Flo1991/ws2811lichterkette/Doxy/rtf/refman.rtf

begin body

TITLE

AUTHOR
Version
CREATEDATE

Table of Contents

Table of contents

Use WS2811/WS2812 LEDs with an AVR

AAAAAAAAFFAAAAAAAAFFIntroduction
This project is about using an WS2811 or WS2812 lightstribe with an AVR controller. It is possible to handle up to 250 LEDs at the same time, so I chose an Atmega328p with enough RAM amount. If you want to handle less LEDs you can use most parts of this project with every AVR. The AVR is programmed to receive the light data over UART so you can control the LEDs by using a serial interface. The interface uses a specified simple protocol which is described in Protocol overview section. Everything has been developed in a university course to control the lights of a Christmas tree. In the original implementation there were some further components included. This is a simplified version of the implementation so that everyone can use it. As an example for controlling the LEDs using a smart phone the Example usage with an ESP8266 section shows how this could be done by using a webserver on the ESP8266. You can use everything else that provide a serial interface (maybe connect with a bluetooth serial module). The structure of this documentation is split in a hardware part for the AVR that describes the basic hardware that should be used. The next part is about how the software is working on the AVR that handles the LEDs and different effects. You may include some more stuff in your own. After that you can see a small protocol overview, where you find which command can be sent to the AVR to control the LEDs. Be aware that at the initialization state all LEDs are off. At the last point you can find an example how to use the implementation with an ESP8266 with a webserver. You will find the source code for the ESP8266 and the basic hardware setup.
AAAAAAAAFIAAAAAAAAFIBasic usage
For using this implementation follow this steps:
set up the hardware as descriped in section Hardware
set the F_CPU clock to the value for your hardware
set the BAUD to the value you like, 76800 or 38400 are suggested
compile your implementation (only O1 optimization is supported)
program your AVR with your binaries
set the clock divider fuse and the clock source fuse referring to your implementation
send protocol data (see section Protocol overview) to the RX pin of the AVR over a serial device, e.g. an FTDI, ESP8266 or Arduino (UART is 8N1 on your chosen BAUD)(example data 254 6 0 1 20 22 = 0xFE 0x06 0x00 0x01 0x14 0x16)

AAAAAAAAFJAAAAAAAAFJHardware
The basic hardware you need is a AVR controller an some WS2811 or WS2812 LEDs you want to control. The AVR controller should have an hardware UART, otherwise you need to write some code for a software serial. In the project we chose an Atmega328p that has enough RAM to control 250 LEDs. The internal software structure buffers the color data for the LEDs to achieve an accurate timing, see section Software implementation. The AVR can be used with the internal clock at 8 MHz, remember to clear the clock divider fuse. Otherwise an external 8 MHz or 16 MHz clock source can be used, the definition F_CPU must be set to the frequency you chose (remember to set the fuses for an external clock source). As an example figure 1 shows using an external 16 MHz crystal. AAAAAAAAFLAAAAAAAAFL

IMAGE
As you can see in the picture the AVR is programmed by using the ISP interface. The WS2812/WS2811 get the same voltage as the AVR, the light data is available at PinB0, you may change this if you like. Referring to the LEDs be aware of the current amount they may draw if every LED has its full brightness. One WS2812 can draw up to 60 mA, so one meter with 30 LEDs already need 1,8 A. If you want to control more LEDs you may have a problem with the voltage drop along the stribe. For example if you control 180 LEDs at six meters you not only need 10,8 A, furthermore you will probably have a voltage drop up to 2 V. To reduce the voltage drop you must increase the wire size with parallel wires to you stribe. You can see the voltage drop if you set all LEDs to white. If you have only a small voltage drop every LED will have the same color. If the voltage drop is too much you can see that the last LEDs will have less blue color, so they will light in a warm white color even up to red. If you want to try out the LEDs with the AVR you can build up everything on a breadboard. Pinheaders can be soldered easy at the light stribes as you can see in figure 2. AAAAAAAAFMAAAAAAAAFM

IMAGE
The connect GND to the common ground with the AVR, 5 V should be connected to a power supply that can handle the current you need. DI is the data in line, this should be connected to PinB0 at the AVR. The stribe is like a big shifting register, all the data you sent is shifted bit by bit through the stribe. So DO is the data out pin, you see some data at this pin if all LEDs before had already received their color data. The one wire protocol of the LEDs is described in the next section Software implementation.
Datasheets:
Datasheet WS2812
Datasheet WS2811
Datasheet Atmega328

AAAAAAAAFKAAAAAAAAFKSoftware implementation
If your hardware is ready you must flash your AVR device with the provided software. Therefore the ISP-6 connector should be used. To get the right timing remember to set the F_CPU definition to the frequency you are working at. Furthermore set the fuses of the AVR referring to your implementation. This means you have to clear the clock divider fuse and may have to change the clock source. I suggest to use the AtmelStudio to program your AVR and its fuses.
The WS2812/WS2811 are controlled by one data line that works with a one wire protocol. Because of the missing clock line the timing is really important, this can either be achieved by doing some trick with the hardware interfaces (e.g. using the spi interface) or by bit banging. In this implementation bit banging is used. To get a good timing all color data must be transmitted in one block that is not interrupted by some other code. The timing specifications of the WS2812/WS2811 LEDs can be found in table 1 which refers to the datasheet ( WS2812 ).
AAAAAAAAFNAAAAAAAAFN
Information | Timing | Tolerance +/-
Transfer 1 Bit | HighTime+LowTime=1,25 µs | 600 ns
send 0, high time | 0,35 µs | 150 ns
send 0, low time | 0,8 µs | 150 ns
send 1, high time | 0,7 µs | 150 ns
send 1, low time | 0,6 µs | 150 ns
data transmission complete, low time | >50 µs | -
Timing table for WS2812/WS2811 one wire protocol
The timing is done by setting the output and wait the required time by doing nothing (call assembly NOPs). So it is important to compile the provided software at O1, other optimization levels may influence the timing. To send one bit (either high or low) two different macros are defined in Lightstribe.h (SETHIGH and SETLOW), one LED needs 24 color bits. The macros depend on the value of F_CPU you entered in globals.h. Furthermore the header file Lightstrib.h declares a color struct to handle 24 bit colors (color24bit) and three basic functions to control the LEDs. The corresponding c file Lightstribe.c implements these functions. The most important function is the transmit2leds function. This function and only this function transmits data to the stribe. All other functions either call this function or manipulate the color array. To achieve the right timing all effects and operations are done on a color array that stores the color information for the LEDs. The information is sent to the LEDs by calling transmit2leds with the lightdata pointer that points to an dynamically allocated array that stores the color information depending on the number of LEDs you want to control. Therefore your color array must at least be able to contain 24 bits x your number of LEDs. It can be bigger, what will allow you to create even more effects (e.g. if you rotate a rainbow array). So the effects that are implemented in LedEffects.c change the color array and afterwards the transmit2leds is called. The c file LedEffects.c not only contains effects but also different necessary functions for the effects and the serial color handling. The colorconv8to24 function converts the received 8 bit colors from the serial port to 24 bit colors for the lightstribes. So you only sent 8 bit colors over the serial port to the AVR to reduce data size. Further information can be found in the Protocol overview section. The colors are decompressed with a simple map function you may know from Arduino. The main.c file initializes the hardware and handles the LEDs. A serial interrupt stores the data temporary. If the data transmission is complete the main function will extract the information and set the new configuration for the lightstribe.
The last points to be mentioned in this section are some things you need to be careful. The first thing is that the 8 bit colors are in an RGB 3-3-2 format. The 24 bit color format depend on the LEDs. WS2812 LEDs use a GRB color scheme while WS2811 use a RGB color scheme. This is important, to achieve the right color the protocol includes a bit that decides the color scheme. The right color is resolved by the decompressing function colorconv8to24. Another thing is that the colors are not linearized, what means that you cannot say that a color you got from a color table will be look like this. As an example you picked an orange from a 3-3-2 rgb color table. This orange will not be the same orange on the LED stribe. This depends on many parameters so linearizing is too much effort and almost impossible (to achieve linearization you would have to measure each color, compare it and evaluate correction parameters).
AAAAAAAAFGAAAAAAAAFGProtocol overview
This section gives an overview of the implemented serial protocol. The goal of the protocol was to be as simple as possible, to be easily implemented on the AVR and to use as less resources as possible. Figure 3 shows the base structure of the protocol. AAAAAAAAFOAAAAAAAAFO

IMAGE
As you can see a data transmission always starts with the preamble 254(0xFE). For a fast and easy implementation this preamble value must only be used as preamble and must never be another field value (e.g. you must not send the color value 254). The next byte that is sent contains the total length of the packet including the preamble and the length byte. If you sent a wrong length you may get an unexpected behavior until a new correct data packet is sent. The third field contains the effect. The different effects are listed in table XXX. In Bit 7 (MSb) you can choose the LED type you want to control, set the bit to 0 for WS2811 and to 1 for WS2812 LEDs. The next byte is a value to control the effect speed. You can set a delay between 0 (no delay) and 250 (longest delay possible). The value unit and is not a repeatable setting for different effects. This means that the delay is no correct wait function (e.g. wait for n milliseconds). Furthermore the effects work on the color array what may be faster for some effects and slower for others. The best thing is to try the effects with different values. The next field contains the number of the LEDs that should be controlled. Be aware that the maximum supported number of LEDs is 250, but this depends on your hardware. The chosen Atmega328p can handle this amount, if you choose an AVR with less RAM this will not work. What you can do is to allocate more LEDs than you actually have. This gives you the possibility to create further effects. What happens is that only a part of the array is sent to the LEDs but the other color values are stored internally in the AVR (in fact all color data is transmitted to the LEDs but the superfluous information is overwritten by new data). The last data field are the color values. One color is 8 bit RGB 3-3-2 and you should sent the right amount of colors for your chosen effect. If you sent to less information the data block will not be evaluated because the total length does not match. For sending some data do not forget to configure your UART (8N1 BAUD) on both sides.
AAAAAAAAFPAAAAAAAAFP
Effect number | Number of colors (1 byte RGB 3-3-2) | Description | Example (decimal)
0 = SETFULLCOLOR | 1 | All LEDs glow at the same color without changes. | 254 6 1 20 22
1 = FILLUP | 2 (foreground, background) | One LED steps through the stribe in the foreground color and colors all LEDs after it in the background color. At the end of the stribe the LED stays at the foreground color and another LED starts to step through the stribe. This continues until the whole stribe is filled in the foreground color. Then the stribe is cleared to the background color and the effects begins again. | 254 7 1 22 20 22 201
2 = BLINK | 1 | The stribe blinks in the chosen color and to off (=black) repeatedly. | 254 6 2 55 20 56
3 = RUNLED | 2 (foreground, background) | All LEDs but one are colored in the background color. The one in the foreground color walks through the stribe with overflowing to the beginning. | 254 7 3 55 20 56 151
5 = ALTERNATE | 2 (foreground, background) | The LEDs are alternating in the foreground and the background color. First the even LEDs are colored in foreground and the uneven in the background color, after that vice versa. | 254 7 5 55 20 56 151
7 = RECOLOR | 1 | The stribe is filled in a new color step by step until the whole stribe stays in the new color. | 254 6 7 55 20 38
8 = FADE | 1 | The destination color is set and the base colors red, green and blue are decreased step by step until the stribe is off. After that the color values are increased until the destination color is reached. This generates a color fading effect. The color fading is not linearized. | 254 6 8 55 20 201
9 = INITRAINBOW | no color | Set the stribe in a static rainbow color. | 254 5 9 0 20
10 = ROTATE_R | no color | Rotate all LEDs one step to the right side (depends on lightdata array). | 254 5 10 232 20
11 = ROTATE_L | no color | Rotate all LEDs one step to the left side (depends on lightdata array). | 254 5 11 23 20
12 = CUSTOM | N colors | All LEDs are set to the static color referring to the sent color values. If there are more LEDs than color values the colors are repeated. | 254 8 12 1 20 22 201 60
Table containing all effects available over the serial protocol
The missing numbers in table 2 are internally used by the AVR and must not be sent over the serial port.
AAAAAAAAFQAAAAAAAAFQImplement further effects
This section tells you how to implement further effects. You may use already existing functions to generate new effects or add something completely new. All effects should be written in the LedEffects.c file and declared in its header file LedEffects.h. You must know that everything works on a lightdata array that contains the colors stored in an array. The array is sent directly to the stribe if the transmit2leds function is called. So you first need to manipulate the array and than send it to the stribe. The array is ordered in GRB color because the implementation has been done for WS2812 LEDs (WS2811 LEDs can be used the colors are converted in the colorconv8to24 function referring to the MSb of the effect you sent, for more information see section Protocol overview). So lightdata[0] contains one byte green data, lightdata[1] one byte red data, lightdata[2] blue data and so on. In general you can say lightdata[N%3==0] contains green, lightdata[N%3==1], lightdata[N%3==2] data. So the color array has a size of MAXNUMCOLORS * 3. So your function must at least have a pointer to the lightdata array as a call value. For creating your effect some nice functions are already implemented you may use. You can find a list of them in table 3.
AAAAAAAAFRAAAAAAAAFR
Function Name | call values | operation
map | x,in_min,in_max,out_min,out_max | calculate an x value to a new number range
effectdelay | delay | wait some time dependend on delay
resetstribe | *lightdata | clear the stribe (all LEDs off)
rotate | *lightdata, direction | rotate stribe by one position (means 3 bytes) in direction (right/left)
rotateN | *lightdata, direction,width | rotate LEDs by "width" positions (means width * 3 bytes) in direction (right/left)
setled | color, *lightdata, lednr | set one LED a position lednr in the chosen color, others off (black)
changeled | color, *lightdata, lednr | change the color of one LED at position lednr, others are unchanged
Provided help functions for your own effect
Your written effect should get an own definition in LedEffects.h . The last thing is to add your definition in the main switch case structure. Referring to the implemented protocol your effect is available with the number you defined in LedEffects.h. You must sent the neccessary information for your effect, for example the color values you need and so on. To get the color value you sent you need to call colorconv8to24 to convert the 8 bit RGB color into a 24 bit color. All colors you sent are available in the CompColorArray. The first color you sent is stored in index zero. Your implemented function must not care about the color order if you use the colorconv8to24 function. This does the conversion depending on the MSb of the effect you sent over the serial port. The delay is handled by the global var effectime and the number of LEDs to control is stored in NumOfLeds. The effect is stored in the effect variable. You should not do any changes on the serial part and the protocol reading, otherwise you will change to complete behavior of this implementation.
AAAAAAAAFSAAAAAAAAFSRequirements and Limitations
The implementation to control has the following requirements and limitations:
colors are 8 bit compressed so you cannot get every color value of the LEDs
the protocol implementation with the preamble 254 prohibits this value for other protocol fields (e.g. color)
approximate amount of RAM (in bytes) you need: MAXNUMCOLORS(=number of LEDs to control)*3 + UART_BUFFER_SIZE *2 + MAXNUMCOLORS + 160
only O1 optimization is supported
8 MHz and 16 MHz clock support
fuses must be programmed manually (clock source and clock divider)
WS2801 stribes not supported (different hardware interface with two wires)
AVR should run on 5 V

AAAAAAAAFHAAAAAAAAFHExample usage with an ESP8266
This section gives a short introduction about using the provided programm with an ESP8266. In this example the ESP8266 works as a wifi hotspot you can connect with and browse a website which allows different settings for the light stribe. The website is quite simple and only a few effects and colors are supported. If you enter the button "DO IT" your configuration is transmitted over the serial interface to the AVR. This is done through a software serial implementation, you find all necessary files below. You should step through all instructions to get the example work.
AAAAAAAAFTAAAAAAAAFTESP8266 setup
First you need to setup the ESP8266. Because of different versions of ESP8266 modules you may miss something, this is just a quick guide. For more information you can browse the web. First you must connect your ESP8266 to a host computer over a serial interface for example using an FTDI. Remember to cross RX and TX of the serial port. Furthermore be aware of the ESP8266 voltage, it is 3,3 V. The current a serial chip may provide (some FTDIs provide some current) may not be enough for the ESP8266 and what can cause different problems.
So first you need to flash your ESP8266 with the nodemcu firmware that provides a software serial. The binaries that have been used in this example can be found here:
Binaries part 1
Binaries part 2
For uploading this binaries to the ESP8266 you should use the nodeMCUFlasher (https://github.com/nodemcu/nodemcu-flasher) that can be found on github. You need to set the serial port to which your ESP8266 is connected with and configure the source files for flashing the firmware. You need to set the COM port to which you ESP8266 is connected to (see figure 4). Furthermore you must consider the following hardware configuration:
3,3 V logic level
bootmode low (IO15)
chip enable high (CH_PD)
reset high (drive low to reset the module)
IO0 low for firmware flashing (high for programming and normal operation)
The firmware programmer waits for the MAC of the ESP8266 module which will be successfully read if everything is done fine. As you can see in figure 4 the firmware programmer is still waiting for an ESP8266. AAAAAAAAFUAAAAAAAAFU

IMAGE
If the ESP8266 is connected right you now set the configuration to the provided binaries as you can see in figure 5. You must browse to the binary files and set the destination address. Now you can hit the "Flash"-Button (see figure 4). AAAAAAAAFVAAAAAAAAFV

IMAGE
After flashing the firmware you need to reboot the ESP8266 module. Before you do this you should change the IO0 to high level (3V3) because after the reboot we want to program the module with our own program. The reset can be done by setting reset low. The program we will upload to the module is written in Lua. Lua is a scripting language that is interpreted by the firmware running on the module. So the performance is not the best, but the programming is quite simple. The little program that you can find below set up the module as an access point, runs a simple webserver that interacts with a software serial to control the AVR. One thing you must know about the Lua programming is that the variable types are assigned implicit so you cannot control whether a number is stored as 16 bit or 32 bit signed or unsigned variable. Another thing you should know is that the program you write needs the full memory space of its file. That means shorter variable names save memory and furthermore documentation should be as short as possible or left.
For writing your program you can use any text editor, notepad++ is a good choice. If you are finished you must upload the file to the module. Therefore you use the same setup as for firmware updating but you must set IO0 to high level. For uploading your program you can use the ESP8266 Lua Loader. It is easy to handle and you can try out several things first, before you upload your code. You can find the main window of the ESP8266 Lua Loader in figure 6. AAAAAAAAFWAAAAAAAAFW

IMAGE
On the right side you can set the baud rate for uploading you program to the module. In the GPIO section you can easily set and reset them to try your wiring. By using the restart button you will restart the module. This may be necessary if your heap (RAM) is to low. This is caused by inefficient programming or by a program that is to big for the module. Global variables need a lot of heap. For uploading your program hit the "Upload File..." button. In a file browser you choose your program that should be transferred to the module. After completion you hit the "dofile" button to run the program. This short description should be enough.
So now we upload the Lua program that starts the webserver and sends data over a software serial to the AVR. You can find this program here:
lua program for controlling the AVR
The program does the following:
set up the ESP8266 module as an access point (SSID=Lichterkette, password=12345678, you may change this)
start a webserver that listens on port 80
load the index.html website and handle requests
sent UART commands matching for the AVR implementation to generate different effects depending on the request
software serial is set to GPIO5 (GPIO5 is available at software number 1)
Some further things you should know:
the maximum of parallel accessing devices is four
parallel devices can never access another device
the software uart only supports TX (8N1 up to 38400 baud)
if you change the website you must change the hard coded content length of the website
the address of the ESP8266 is always 192.168.4.1

AAAAAAAAFXAAAAAAAAFXConnect ESP8266 with AVR
After uploading the main program file you need to upload the _index.html file. Before uploading remove the underscore so that the files name is index.html (the underscore has been inserted because of conflicts with this html documentation). For uploading other file types (than lua programs) to your ESP8266 module you need to use the "Upload Bin" button of the Lua Loader. The file will be uploaded to the file system on the ESP8266.
Now your ESP8266 module is ready to try the first communication with the AVR. So now you need a hardware setup where the ESP8266 and AVR are connected. Be aware of the different voltage levels (AVR uses 5V, ESP8266 3V3). You should connect everything like figure 7 shows.
AAAAAAAAFYAAAAAAAAFY

IMAGE
Your ESP8266 should still be connected with the host computer. If your hardware setup is ready you now must hit the "dofile" button in the Lua Loader (complexe_server.lua must be the selected file that should be executed). After a short time you can use any device to search for the access point that is set up by the ESP8266 module. It will have your SSID (default "Lichterkette") and your chosen password (default "12345678"). After you connected to your ESP8266 module you should open a web browser and browse the IP address 192.168.4.1. The browser should load the website. Now choose your configuration for the LEDs and hit the "DO IT" Button on the website. The website should be reloaded and the lightstribes get the configuration you have chosen. If everything is working fine the last thing to do is to make the ESP8266 as a stand alone device without the need of an external host. For this you must remove the complex_webserver.lua file from the module. Now you rename the file on your host computer to init.lua. Afterwards you upload this file to the ESP8266. This file is always loaded at first when the ESP8266 is powered on. So now you have a stand alone webserver that communicates with your AVR for controlling WS2811/WS2812 LEDs.

AAAAAAAAFZAAAAAAAAFZShort setup

flash the provided image (Binaries part 1 ,Binaries part 2
upload the _index.html renamed to index.html
upload the lua program complex_server.lua renamed to init.lua
setup your hardware refering to figure 7
connect to your ESP8266 with your SSID and your password (default: Lichterkette, 12345678)
browse 192.168.4.1 on your device
set up your configuration and hit "DO IT"

author: Florian Wank, 2016

Data Structure Index
Data Structures
Here are the data structures with brief descriptions:
color24bit (24 Bit color structure RGB 8-8-8 ) pagenum

File Index
File List
Here is a list of all documented files with brief descriptions:
globals.h (File that contains basic and global definitions, changes should be done carefully ) pagenum
LedEffects.c (Effect functions for controlling WS2811/WS2812 LEDs ) pagenum
LedEffects.h (File that contains different effect definitions for the lightstribe ) pagenum
Lightstribe.c (Basic functions for controlling WS2811/WS2812 LEDs ) pagenum
Lightstribe.h (Basic functions for controlling WS2811/WS2812 LEDs ) pagenum
ws2811lichterkette.c (Main file for interfacing WS2811/WS2812 LEDs ) pagenum

Data Structure Documentation
color24bit Struct Reference
AAAAAAAAATAAAAAAAAAT
24 Bit color structure RGB 8-8-8
#include <Lightstribe.h>

Data Fields
uint8_t redAAAAAAAAAWAAAAAAAAAW
8 Bit red
uint8_t greenAAAAAAAAAXAAAAAAAAAX
8 Bit green
uint8_t blueAAAAAAAAAVAAAAAAAAAV
8 Bit blue

Detailed Description
24 Bit color structure RGB 8-8-8
Definition at line 16 of file Lightstribe.h.

The documentation for this struct was generated from the following file:
Lightstribe.h

File Documentation
globals.h File Reference
AAAAAAAAAPAAAAAAAAAP
file that contains basic and global definitions, changes should be done carefully
#include <stdint.h>

Macros
#define _STR_EXPAND(tok) #tokAAAAAAAADIAAAAAAAADI

#define _STR(tok) _STR_EXPAND(tok)AAAAAAAADJAAAAAAAADJ

#define _CPU_INFO(x) CPU_FREQUENCY##xAAAAAAAADKAAAAAAAADK

#define EXTERN externAAAAAAAAAAAAAAAAAAAA

macro for global variable management
#define BASELEDTYPE 11AAAAAAAACPAAAAAAAACP

default LED type of the stribe (11 for WS2811, do not change here! change ledtype in main function!)
#define MAXNUMCOLORS 50AAAAAAAAAFAAAAAAAAAF

definition for maximum number of different colors that can be handled at the same time (the maximum value should be 250, a higher value may result in an memory overflow refering to 2kByte (atmega328p))
#define UART_BUFFER_SIZE 80AAAAAAAAAHAAAAAAAAAH

definition for UART Buffer, must be at least MAXNUMCOLORS+5
#define F_CPU 8000000AAAAAAAADLAAAAAAAADL

CPU Frequency definition for avr delay function.
Variables
EXTERN uint8_t NumOfLedsAAAAAAAAABAAAAAAAAAB
global variable for number of leds to control
EXTERN uint16_t effectimeAAAAAAAAACAAAAAAAAAC
global effectime for effect delays, a higher value means a higher delay
EXTERN uint8_t ledtypeAAAAAAAAADAAAAAAAAAD
global ledtype, 11 = WS2811 (RGB Color), 12 = WS2812 (GRB Color)
EXTERN uint8_t CompColorArray [MAXNUMCOLORS]AAAAAAAAAEAAAAAAAAAE
color array containing the received packed 8-Bit colors
EXTERN uint8_t RecBuffer [UART_BUFFER_SIZE]AAAAAAAAAGAAAAAAAAAG
receive buffer for UART communication
EXTERN uint8_t BufferCounterAAAAAAAAAIAAAAAAAAAI
counter for accessing the CompColorArray indices for data income
EXTERN uint8_t DataLenAAAAAAAAAJAAAAAAAAAJ
variable to store the current packet length of the UART packet
EXTERN uint8_t effectAAAAAAAAAKAAAAAAAAAK
global effect variable to switch between the effects
EXTERN uint8_t PacketCompleteAAAAAAAAALAAAAAAAAAL
flag to store if a UART packet is complete; a packet is complete if the BufferCounter equals DataLen
EXTERN uint8_t PaketStartAAAAAAAAAMAAAAAAAAAM
flag to store if the PREAMBLE has been received
EXTERN uint8_t IsReadingAAAAAAAAANAAAAAAAAAN
flag to show if the RecBuffer is in copy process so that the array cannot be filled with new data from UART
EXTERN volatile char ReceivedCharAAAAAAAAAOAAAAAAAAAO
current data received from UART

Detailed Description
file that contains basic and global definitions, changes should be done carefully

Version:
V1.00
Date:
05.01.2016
Authors:
Wank Florian
Definition in file globals.h.

globals.h
1 /**************************************************************************/
9 #include <stdint.h>
10
11 #ifndef GLOBALS_H_
12 #define GLOBALS_H_
13
14 //macros to display infos for CPU Frequency or other defines
15 #define _STR_EXPAND(tok) #tok
16 #define _STR(tok) _STR_EXPAND(tok)
17 #define _CPU_INFO(x) CPU_FREQUENCY##x
18
20 #ifndef EXTERN
21 #define EXTERN extern
22 #endif
23
25 EXTERN uint8_t NumOfLeds;
27 EXTERN uint16_t effectime;
29 EXTERN uint8_t ledtype;
31 #define BASELEDTYPE 11
32
35 #define MAXNUMCOLORS 50
36
37 #define UART_BUFFER_SIZE 80
38
40 EXTERN uint8_t CompColorArray[MAXNUMCOLORS];
42 EXTERN uint8_t RecBuffer[UART_BUFFER_SIZE];
44 EXTERN uint8_t BufferCounter;
46 EXTERN uint8_t DataLen;
48 EXTERN uint8_t effect;
49
50 //EXTERN uint8_t speed;
51
53 EXTERN uint8_t PacketComplete;
55 EXTERN uint8_t PaketStart;
57 EXTERN uint8_t IsReading;
59 EXTERN volatile char ReceivedChar;
60
62 #ifndef F_CPU
63 #define F_CPU 8000000
64 #endif
65 #endif /* GLOBALS_H_ */

LedEffects.c File Reference
AAAAAAAADNAAAAAAAADN
effect functions for controlling WS2811/WS2812 LEDs
#include "globals.h"

#include "Lightstribe.h"

#include "LedEffects.h"

#include <util/delay.h>

Functions
uint8_t map (uint8_t x, uint8_t in_min, uint8_t in_max, uint8_t out_min, uint8_t out_max)
Arduino map function; used for color conversion.
struct color24bit colorconv8to24 (uint8_t startcolor)
color conversion function; converts a 8 Bit color (RGB 3-3-2) to a 24 Bit color (RGB 8-8-8)
void effectdelay (uint16_t delay)
simple delay function; no concrete delay time
void setfullcolor (struct color24bit color, uint8_t *lightdata)
Set all LEDs to the chosen color; run transmit2leds afterwards to update the LEDs.
void resetstribe (uint8_t *lightdata)
Set all LEDs off; run transmit2leds afterwards to update the LEDs.
void rotate (uint8_t *lightdata, uint8_t direction)
Rotate the lightdata for 1 LED Position; run transmit2leds afterwards to update the LEDs.
void rotateN (uint8_t *lightdata, uint8_t direction, uint8_t width)
Rotate the lightdata for n LED Positions; run transmit2leds afterwards to update the LEDs.
void initrunled (struct color24bit color, uint8_t *lightdata, struct color24bit background)
init the runled effect; run runrunled afterwards to start the effect
void runrunled (uint8_t *lightdata, uint8_t direction)
Do the runled effect; before this function is called the lightdata needs to be initiliazed using initrunled!
void blinkled (struct color24bit color, uint8_t *lightdata)
blink the whole stribe; this function does not need another function call
void init_alternating (struct color24bit color, struct color24bit backcolor, uint8_t *lightdata)
initialize the alternating function; call run_alternating afterwards
void run_alternating (uint8_t *lightdata)
Run the alternating effect; call init_alternating before.
void recolor (struct color24bit color, uint8_t *lightdata)
Recolor the LED stribe; no other function call is necessary.
void faden (struct color24bit color, uint8_t *lightdata)
Generate a fading color effect. No other function call is necessary.
void initrainbow (uint8_t *lightdata)
Initialize a rainbow on the color array; to show the rainbow run transmit2leds afterwards.
void eastereggbase (struct color24bit color, uint8_t *lightdata)
Initialize the easteregg; do not use directly; this function is used by the easteregg function.
void easteregg (uint8_t *lightdata)
Run the easteregg; No other function call is necessary.
void fillup (struct color24bit color, struct color24bit backcolor, uint8_t *lightdata)
This function fills up the stribe; No other function call is necessary.

Detailed Description
effect functions for controlling WS2811/WS2812 LEDs
This file contains different effect functions to control WS2811/WS2812 LEDs using an AVR. It also contains a conversion function to convert 8 Bit color values (RGB 3-3-2) to 24 Bit color values (RGB/GRB 8-8-8). The effects control first the lightdata array and then transmit the array data to the stribe. Using different operations result in different effects. You can add different functions if you like to. But remember that all operations need to be done on the lightdata array that needs to be transmitted at one block to the LEDs after your array has been changed.
Version:
V1.00
Date:
05.01.2016
Authors:
Wank Florian
Definition in file LedEffects.c.

Function Documentation
void blinkled (struct color24bit color, uint8_t * lightdata)
AAAAAAAABHAAAAAAAABH
blink the whole stribe; this function does not need another function call
This function creates a blinking effect. First all LEDs are set to the chosen color, after the defined delay the LEDs are turned off. This is repeated in the main while loop.
Parameters:
in | struct | color24bit color : color for the blink effect
in | uint8_t | *lightdata : lightdata array that holds the color values for the stribe
Returns: void
Note:
No need to run transmit2leds afterwards! This is already done in the function.
Definition at line 278 of file LedEffects.c.
References effectdelay()effectdelay(), effectimeeffectime, resetstribe()resetstribe(), setfullcolor()setfullcolor(), and transmit2leds()transmit2leds().
Referenced by main()main().
struct color24bit colorconv8to24 (uint8_t startcolor)
AAAAAAAAAUAAAAAAAAAU
color conversion function; converts a 8 Bit color (RGB 3-3-2) to a 24 Bit color (RGB 8-8-8)

Parameters:
in | uint8_t | startcolor: 8 Bit color to convert
Returns: struct color24bit : 24 Bit color result
Note:
This function converts the 8 Bit color to a 24 Bit color depending on the ledtype. This is neccessary because of differnt color formats (WS2811->RGB ; WS2812->GRB). Original the whole environment was for WS2812 LEDs!
Definition at line 45 of file LedEffects.c.
References color24bit::bluecolor24bit::blue, color24bit::greencolor24bit::green, ledtypeledtype, map()map(), and color24bit::redcolor24bit::red.
Referenced by easteregg()easteregg(), and main()main().
void easteregg (uint8_t * lightdata)
AAAAAAAABOAAAAAAAABO
Run the easteregg; No other function call is necessary.

Parameters:
in | uint8_t | *lightdata : lightdata array that holds the color values for the stribe
Returns: void
Note:
Just try it :-) funny looking effect
Definition at line 514 of file LedEffects.c.
References colorconv8to24()colorconv8to24(), eastereggbase()eastereggbase(), and PacketCompletePacketComplete.
Referenced by main()main().
void eastereggbase (struct color24bit color, uint8_t * lightdata)
AAAAAAAABNAAAAAAAABN
Initialize the easteregg; do not use directly; this function is used by the easteregg function.

Parameters:
in | struct | color24bit color : color for the easteregg
in | uint8_t | *lightdata : lightdata array that holds the color values for the stribe
Returns: void
Note:
Do not use this function directly; this function is used by the easteregg function
Definition at line 489 of file LedEffects.c.
References changeled()changeled(), effectdelay()effectdelay(), effectimeeffectime, NumOfLedsNumOfLeds, PacketCompletePacketComplete, rotate()rotate(), and transmit2leds()transmit2leds().
Referenced by easteregg()easteregg().
void effectdelay (uint16_t delay)
AAAAAAAAAYAAAAAAAAAY
simple delay function; no concrete delay time

Parameters:
in | uint16_t | delay : delay value
Returns: void
Note:
This function is just a variable delay, there is no coherence with a concrete time (i.e. s, ms)
Definition at line 72 of file LedEffects.c.
References PacketCompletePacketComplete.
Referenced by blinkled()blinkled(), eastereggbase()eastereggbase(), faden()faden(), fillup()fillup(), main()main(), recolor()recolor(), run_alternating()run_alternating(), and runrunled()runrunled().
void faden (struct color24bit color, uint8_t * lightdata)
AAAAAAAABLAAAAAAAABL
Generate a fading color effect. No other function call is necessary.
This function generates a fading color effect. At the beginning the whole stribe is filled with the chosen color. The color intensity of each color channel (blue, red, green) is decreased until the stribe is off. After that the color values are increased until the chosen color values are reached. The effect looks different depending on the chosen color because the color value proportion is not kept over the whole effect.
Parameters:
in | struct | color24bit color : color that is used for the fading effect
in | uint8_t | *lightdata : lightdata array that holds the color values for the stribe
Returns: void
Note:
No need to run transmit2leds afterwards! The effect is standalone and ends is looped in the main while loop. The color value proportion is not kept over the whole effect.
Definition at line 366 of file LedEffects.c.
References color24bit::bluecolor24bit::blue, effectdelay()effectdelay(), effectimeeffectime, color24bit::greencolor24bit::green, PacketCompletePacketComplete, color24bit::redcolor24bit::red, setfullcolor()setfullcolor(), and transmit2leds()transmit2leds().
Referenced by main()main().
void fillup (struct color24bit color, struct color24bit backcolor, uint8_t * lightdata)
AAAAAAAABPAAAAAAAABP
This function fills up the stribe; No other function call is necessary.
This function fills up the whole stribe and beginns again if it is finished. First one LED moves in the chosen color stepwise through the whole stribe and recolors all LEDs in the background color which have already been passed. At the end of the stribe the LED stays an the next single LED is going to move to the last-1 position. The next LED to the last-2 position. This is going on until the whole stribe is colored. Then the effect restarts (main while loop).
Parameters:
in | struct | color24bit color : foreground color for the moving LED
in | struct | color24bit backcolor : background color
in | uint8_t | *lightdata : lightdata array that holds the color values for the stribe
Returns: void
Note:
This is a standalone effect.
Definition at line 549 of file LedEffects.c.
References changeled()changeled(), effectdelay()effectdelay(), effectimeeffectime, NumOfLedsNumOfLeds, PacketCompletePacketComplete, and transmit2leds()transmit2leds().
Referenced by main()main().
void init_alternating (struct color24bit color, struct color24bit backcolor, uint8_t * lightdata)
AAAAAAAABIAAAAAAAABI
initialize the alternating function; call run_alternating afterwards
This function initializes the alternating effect. The effect assigns every even LED number in one color and the odd numbers in the background color. If the effect is running, the odd and even LED switch positions.
Parameters:
in | struct | color24bit color : color for the alternate effect (Init even LEDs)
in | struct | color24bit backcolor : color for the alternate effect bakckground (Init odd LEDs)
in | uint8_t | *lightdata : lightdata array that holds the color values for the stribe
Returns: void
Note:
Run run_alternating afterwards to start the effect!
Definition at line 300 of file LedEffects.c.
References changeled()changeled(), NumOfLedsNumOfLeds, and setfullcolor()setfullcolor().
Referenced by main()main().
void initrainbow (uint8_t * lightdata)
AAAAAAAABMAAAAAAAABM
Initialize a rainbow on the color array; to show the rainbow run transmit2leds afterwards.
This function fills the color array with rainbow colors. For this effect the color array is filled with different colors that are calculated by increasing and decreasing the color channels to loop over a RGB palette.
Parameters:
in | uint8_t | *lightdata : lightdata array that holds the color values for the stribe
Returns: void
Note:
Run transmit2leds afterwards! A nice effect is to rotate the array stepwise after the rainbow initialization (run transmit2leds after every rotation). The effect directly sets color values, so there may be a problem with the color profiles (RGB vs. GRB). The function was primary written for WS2812 LEDs (GRB)! The effect needs a minimum number of 20 LEDs to look nice!
Definition at line 442 of file LedEffects.c.
References color24bit::bluecolor24bit::blue, changeled()changeled(), color24bit::greencolor24bit::green, NumOfLedsNumOfLeds, and color24bit::redcolor24bit::red.
Referenced by main()main().
void initrunled (struct color24bit color, uint8_t * lightdata, struct color24bit background)
AAAAAAAABDAAAAAAAABD
init the runled effect; run runrunled afterwards to start the effect
This function initializes the running LED effect. The running LED effect has a background color that is used for all LEDs except one. One LED is in the foreground color an moves stepwise along the stribe. The initialization prepares the lightdata array by setting one LED at the start position and filling the others with the background color.
Parameters:
in | struct | color24bit color : 24 Bit color for the effect
in | uint8_t | *lightdata : lightdata array that holds the color values for the stribe
in | struct | color24bit background : 24 Bit color for the effect background
Returns: void
Note:
Run runrunled afterwards to start the effect!
Definition at line 217 of file LedEffects.c.
References changeled()changeled(), and setfullcolor()setfullcolor().
Referenced by main()main().
uint8_t map (uint8_t x, uint8_t in_min, uint8_t in_max, uint8_t out_min, uint8_t out_max)
AAAAAAAAASAAAAAAAAAS
Arduino map function; used for color conversion.

Parameters:
in | uint8_t | x: value to map
in | uint8_t | in_min : minimum value input reference
in | uint8_t | in_max : maximum value input reference
in | uint8_t | out_min : minimum value output reference
in | uint8_t | out_max : maximum value output reference
Returns: uint8_t : mapped value referring to the input
Note:
This function is used for color conversion from 8 Bit to 24 Bit colors; How it works: in_min < x < in_max convert to out_min < returnvalue < out_max by positioning the x proportionally in the new number range
Definition at line 33 of file LedEffects.c.
Referenced by colorconv8to24()colorconv8to24().
void recolor (struct color24bit color, uint8_t * lightdata)
AAAAAAAABKAAAAAAAABK
Recolor the LED stribe; no other function call is necessary.
This function generates a recolor effect. The old configuration of the LEDs is overwritten with the new color step by step. When the whole stribe is filled with the new color the effect ends.
Parameters:
in | struct | color24bit color : color that is used for recoloring
in | uint8_t | *lightdata : lightdata array that holds the color values for the stribe
Returns: void
Note:
No need to run transmit2leds afterwards! The effect is standalone and ends if the stribe is recolored.
Definition at line 340 of file LedEffects.c.
References changeled()changeled(), effectdelay()effectdelay(), effectimeeffectime, NumOfLedsNumOfLeds, PacketCompletePacketComplete, and transmit2leds()transmit2leds().
Referenced by main()main().
void resetstribe (uint8_t * lightdata)
AAAAAAAABAAAAAAAAABA
Set all LEDs off; run transmit2leds afterwards to update the LEDs.

Parameters:
in | uint8_t | *lightdata : lightdata array that holds the color values for the stribe
Returns: void
Note:
This function sets the lightdata array to 0x00. To update the stribe run transmit2leds afterwards!
Definition at line 118 of file LedEffects.c.
References color24bit::bluecolor24bit::blue, color24bit::greencolor24bit::green, color24bit::redcolor24bit::red, and setfullcolor()setfullcolor().
Referenced by blinkled()blinkled().
void rotate (uint8_t * lightdata, uint8_t direction)
AAAAAAAABBAAAAAAAABB
Rotate the lightdata for 1 LED Position; run transmit2leds afterwards to update the LEDs.

Parameters:
in | uint8_t | *lightdata : lightdata array that holds the color values for the stribe
in | uint8_t | direction : direction to rotate
Returns: void
Note:
This function rotates lightdata array. To update the stribe run transmit2leds afterwards! The rotation "moves every LED" by one step, the overflowing LED is appended at the other ending. Example: RED BLUE YELLOW GREEN ... rotate... BLUE YELLOW GREEN RED other direction: RED BLUE YELLOW GREEN ... rotate... GREEN RED BLUE YELLOW
Definition at line 138 of file LedEffects.c.
References NumOfLedsNumOfLeds.
Referenced by eastereggbase()eastereggbase(), main()main(), rotateN()rotateN(), run_alternating()run_alternating(), and runrunled()runrunled().
void rotateN (uint8_t * lightdata, uint8_t direction, uint8_t width)
AAAAAAAABCAAAAAAAABC
Rotate the lightdata for n LED Positions; run transmit2leds afterwards to update the LEDs.

Parameters:
in | uint8_t | *lightdata : lightdata array that holds the color values for the stribe
in | uint8_t | direction : direction to rotate
in | uint8_t | width : width to rotate
Returns: void
Note:
This function rotates lightdata array. To update the stribe run transmit2leds afterwards! The rotation "moves every LED" by n steps, the overflowing LEDs are appended at the other ending. Example: RED BLUE YELLOW GREEN PINK ... rotate 2 ... YELLOW GREEN PINK RED BLUE other direction: RED BLUE YELLOW GREEN PINK ... rotate 2 ... GREEN PINK RED BLUE YELLOW
Definition at line 196 of file LedEffects.c.
References rotate()rotate().
void run_alternating (uint8_t * lightdata)
AAAAAAAABJAAAAAAAABJ
Run the alternating effect; call init_alternating before.
This function runs the alternating effect. The effect assigns every even LED number in one color and the odd numbers in the background color. If the effect is running, the odd and even LED switch positions. This function rotates the LEDs by one position to achieve the effect. The rotation direction is not of importance.
Parameters:
in | uint8_t | *lightdata : lightdata array that holds the color values for the stribe
Returns: void
Note:
No need to run transmit2leds afterwards! The effect is generated by the main while loop.
Definition at line 323 of file LedEffects.c.
References effectdelay()effectdelay(), effectimeeffectime, rotate()rotate(), and transmit2leds()transmit2leds().
Referenced by main()main().
void runrunled (uint8_t * lightdata, uint8_t direction)
AAAAAAAABFAAAAAAAABF
Do the runled effect; before this function is called the lightdata needs to be initiliazed using initrunled!
This function runs the running LED effect. The running LED effect has a background color that is used for all LEDs except one. The one LED moves stepwise to the next position depending on the chosen direction. Direction 0/1 are right/left, direction 2 runs from left to right an back again. For direction 0/1 the running LED overflows and begins on the other ending.
Parameters:
in | uint8_t | *lightdata : lightdata array that holds the color values for the stribe
in | uint8_t | direction : movement direction, 0/1 = right/left, 2 = left->right and back
Returns: void
Note:
No need to run transmit2leds afterwards! This is already done in the function. The function is interrupted if a new UART package is completely received so a new effect gets active.
Definition at line 236 of file LedEffects.c.
References effectdelay()effectdelay(), effectimeeffectime, NumOfLedsNumOfLeds, PacketCompletePacketComplete, rotate()rotate(), and transmit2leds()transmit2leds().
Referenced by main()main().
void setfullcolor (struct color24bit color, uint8_t * lightdata)
AAAAAAAAAZAAAAAAAAAZ
Set all LEDs to the chosen color; run transmit2leds afterwards to update the LEDs.

Parameters:
in | struct | color24bit color : color to set
in | uint8_t | *lightdata : lightdata array that holds the color values for the stribe
Returns: void
Note:
This function sets the lightdata array. To update the stribe run transmit2leds afterwards!
Definition at line 96 of file LedEffects.c.
References color24bit::bluecolor24bit::blue, color24bit::greencolor24bit::green, NumOfLedsNumOfLeds, and color24bit::redcolor24bit::red.
Referenced by blinkled()blinkled(), faden()faden(), init_alternating()init_alternating(), initrunled()initrunled(), main()main(), and resetstribe()resetstribe().

LedEffects.c
1 /**************************************************************************/
16 #include "globals.h"
17 #include "Lightstribe.h"
18 #include "LedEffects.h"
19 #include <util/delay.h>
20
33 uint8_t map(uint8_t x, uint8_t in_min, uint8_t in_max, uint8_t out_min, uint8_t out_max)
34 {
35 return (x - in_min) * (out_max - out_min) / (in_max - in_min) + out_min;
36 }
37
45 struct color24bit colorconv8to24(uint8_t startcolor)
46 {
47 struct color24bit color;
48 if (ledtype==11)
49 { //color conversion for WS2811 LEDs (RGB color)
50 //the converted values are assigned to the colors of the struct, red an green are switched
51 //because of the different color profiles
52 color.blue =map((0b00000011 & startcolor),0,3,0,255); //2 Bit blue converted to 8 bit
53 color.red=map((0b00011100 & startcolor)>>2,0,7,0,255); //3 Bit green converted to 8 bit, assigned to red (color profiles!)
54 color.green=map((0b11100000 & startcolor)>>5,0,7,0,255);//3 Bit red converted to 8 bit, assigned to green (color profiles!)
55 }
56 else
57 { //color conversion for WS2812 LEDs (GRB color)
58 //the converted values are assigned to the colors of the struct
59 //no color switching is done, the environment is for WS2812 LEDs (GRB)
60 color.blue =map((0b00000011 & startcolor),0,3,0,255); //2 Bit blue
61 color.green=map((0b00011100 & startcolor)>>2,0,7,0,255);//3 Bit green
62 color.red=map((0b11100000 & startcolor)>>5,0,7,0,255); //3 Bit red
63 }
64 return color;
65 }
66
72 void effectdelay(uint16_t delay)
73 {
74 uint16_t j;
75 if (delay==0)
76 return;
77 do
78 {
79 j=2000;
80 if (PacketComplete==1) //interrupt the function if new settings have been received
81 break;
82 do
83 {
84 asm ("nop");
85 } while (--j);
86 } while (--delay);
87
88 }
89
96 void setfullcolor(struct color24bit color, uint8_t *lightdata)
97 {
98 uint8_t ledcolor;
99 uint16_t i;
100 for (i=0;i<NumOfLeds*3;i++) //Loop over color array (lightdata)
101 {
102 ledcolor = i%3;
103 //set the array elements
104 if (ledcolor==0)
105 *lightdata++=color.green;
106 else if(ledcolor==1)
107 *lightdata++=color.red;
108 else
109 *lightdata++=color.blue;
110 }
111 }
112
118 void resetstribe(uint8_t *lightdata)
119 {
120 struct color24bit color;
121 color.blue = 0x00;
122 color.green= 0x00;
123 color.red = 0x00;
124 setfullcolor(color, lightdata);
125 }
126
138 void rotate(uint8_t *lightdata, uint8_t direction)
139 {
140 uint8_t temp1, temp2, temp3;
141 uint8_t *tempp;
142 uint16_t i;
143
144 if (direction==0)
145 {
146 //Store overflowing LED
147 temp1 = *lightdata;
148 temp2= *(lightdata+1);
149 temp3 =*(lightdata+2);
150 //Rotate the array (minus 1 LED-->overflow; 1 LED correlate three 8 Bit color values)
151 for (i=0;i<NumOfLeds*3-3;i++)
152 { //increase the array pointer step by step
153 *lightdata = *(lightdata+3);
154 lightdata++;
155 }
156 //assign overflowed LED
157 *lightdata++ = temp1;
158 *lightdata++ = temp2;
159 *lightdata++ = temp3;
160
161 }
162 else
163 {
164 //Set a pointer to the end of the lightdata
165 tempp = lightdata + NumOfLeds*3 -1;
166 //Store overflowing LED
167 temp1 = *tempp;
168 temp2 = *(tempp-1);
169 temp3 = *(tempp-2);
170
171 //Rotate the array (minus 1 LED-->overflow; 1 LED correlate three 8 Bit color values)
172 for (i=0;i<(NumOfLeds*3-3);i++)
173 { //decrease the array pointer step by step
174 *tempp = *(tempp-3);
175 tempp--;
176 }
177 //assign overflowed LED
178 *tempp--=temp1;
179 *tempp--=temp2;
180 *tempp = temp3;
181 }
182 }
183
196 void rotateN(uint8_t *lightdata, uint8_t direction, uint8_t width)
197 {
198 uint8_t i;
199 for (i=0;i<width;i++)
200 {
201 rotate(lightdata,direction);
202 }
203 }
204
217 void initrunled(struct color24bit color, uint8_t *lightdata, struct color24bit background)
218 {
219 setfullcolor(background,lightdata);
220 changeled(color, lightdata,0);
221 }
222
236 void runrunled(uint8_t *lightdata, uint8_t direction)
237 {
238 uint8_t i;
239
240 //Run from left to right and back, one loop in this function, main while repeats the effect
241 if (direction==2)
242 {
243 for (i=0;i<NumOfLeds;i++)
244 {
245 transmit2leds(lightdata);
246 rotate(lightdata,1);
247 effectdelay(effectime);
248 if (PacketComplete==1)
249 break;
250 }
251 for (i=0;i<NumOfLeds;i++)
252 {
253
254 rotate(lightdata,0);
255 transmit2leds(lightdata);
256 effectdelay(effectime);
257 if (PacketComplete==1)
258 break;
259 }
260 }
261 else
262 { //Only one rotation is done, main while does the effect
263 rotate(lightdata,direction);
264 transmit2leds(lightdata);
265 effectdelay(effectime);
266 }
267 }
268
278 void blinkled(struct color24bit color, uint8_t *lightdata)
279 {
280 //Set the chosen color
281 setfullcolor(color, lightdata);
282 transmit2leds(lightdata);
283 effectdelay(effectime);
284 //Turn the stribe off
285 resetstribe(lightdata);
286 transmit2leds(lightdata);
287 effectdelay(effectime);
288 }
289
300 void init_alternating(struct color24bit color, struct color24bit backcolor, uint8_t *lightdata)
301 {
302 uint16_t i;
303 setfullcolor(backcolor, lightdata); //Set background color
304 for (i=0;i<NumOfLeds;i++)
305 {
306 if(i%2==0)
307 {
308 changeled(color,lightdata,i); //set the even LEDs
309 }
310 }
311 }
312
323 void run_alternating(uint8_t *lightdata )
324 {
325 transmit2leds(lightdata);
326 effectdelay(effectime);
327 rotate(lightdata,1);
328 }
329
340 void recolor(struct color24bit color, uint8_t *lightdata)
341 {
342 uint8_t i;
343 for (i=0;i<NumOfLeds;i++)
344 {
345 changeled(color,lightdata,i);
346 transmit2leds(lightdata);
347 effectdelay(effectime);
348 if (PacketComplete==1)
349 break;
350 }
351 }
352
366 void faden(struct color24bit color, uint8_t *lightdata)
367 {
368 uint8_t i;
369 uint8_t maxgreen, maxred, maxblue;
370 maxgreen =color.green;
371 maxblue = color.blue;
372 maxred = color.red;
373 for (i=0;i<255;i++) //Fade down to LED off
374 {
375 setfullcolor(color,lightdata);
376 transmit2leds(lightdata);
377 effectdelay(effectime);
378 //Decrease the color values that are greater than 0, stop if every value is 0
379 if (color.green > 0)
380 {
381 --color.green;
382 }
383 if (color.blue > 0)
384 {
385 --color.blue;
386 }
387 if (color.red > 0)
388 {
389 --color.red;
390 }
391 if (color.red == 0 && color.blue == 0 && color.green == 0)
392 {
393 break;
394 }
395 if (PacketComplete==1)
396 {
397 break;
398 }
399 }
400
401 for (i=0;i<255;i++) //Fade up to chosen color
402 {
403 setfullcolor(color,lightdata);
404 transmit2leds(lightdata);
405 effectdelay(effectime);
406 //Increase the color values is they are lower than the chosen color value, stop if all maximums are reached
407 if (color.green < maxgreen)
408 {
409 ++color.green;
410 }
411 if (color.blue < maxblue)
412 {
413 ++color.blue;
414 }
415 if (color.red < maxred)
416 {
417 ++color.red;
418 }
419 if (color.red == maxred && color.blue == maxblue && color.green == maxgreen)
420 {
421 break;
422 }
423 if (PacketComplete==1)
424 {
425 break;
426 }
427 }
428 }
429
442 void initrainbow(uint8_t *lightdata)
443 {
444 uint8_t steps = NumOfLeds / 5;
445 struct color24bit color;
446 uint8_t i,j;
447 //Start rainbow with red color
448 color.red = 0xFF;
449 color.blue= 0x00;
450 color.green=0x00;
451 j=0;
452 for(i=0;i<NumOfLeds;i++)
453 {
454 if (j<steps)
455 {
456 color.blue = 0x00+0xFF/steps*j; //increase blue to get violett
457 }
458 else if(j>steps && j<=2*steps)
459 {
460 color.red = 0xFF-0xFF/steps*(j/2); //decrease red to get blue
461 }
462 else if(j>2*steps && j<=3*steps)
463 {
464 color.green = 0x00+0xFF/steps*(j/3);//increase green to get cyan
465 }
466 else if(j>3*steps && j<=4*steps)
467 {
468 color.blue = 0xFF-0xFF/steps*(j/4); //decrease blue to get green
469 }
470 else if(j>4*steps && j<=5*steps)
471 {
472 color.red = 0x00+0xFF/steps*(j/5); //increase red to get yellow
473 }
474 else if(j>6*steps)
475 {
476 color.green = 0xFF-0xFF/steps*(j/6);//decrease green to get red
477 }
478 j++;
479 changeled(color,lightdata,i);
480 }
481 }
482
489 void eastereggbase(struct color24bit color, uint8_t *lightdata)
490 {
491 uint8_t i,j;
492 uint8_t n;
493 j=NumOfLeds;
494 for (i=0;i<NumOfLeds;i++)
495 {
496 n=(j-i);
497 changeled(color,lightdata,0);
498 while(n-->0)
499 {
500 rotate(lightdata,1);
501 transmit2leds(lightdata);
502 effectdelay(effectime);
503 }
504 if (PacketComplete==1)
505 break;
506 }
507 }
508
514 void easteregg(uint8_t *lightdata)
515 {
516 struct color24bit color, color2;
517 uint8_t i;
518 color=colorconv8to24(252);
519 color2=colorconv8to24(201);
520 eastereggbase(color2,lightdata);
521 for (i=0;i<100;i++)
522 {
523 if (PacketComplete==1)
524 break;
525 _delay_ms(50);
526 }
527 eastereggbase(color,lightdata);
528 for (i=0;i<100;i++)
529 {
530 if (PacketComplete==1)
531 break;
532 _delay_ms(50);
533 }
534 }
535
549 void fillup(struct color24bit color,struct color24bit backcolor, uint8_t *lightdata)
550 {
551 uint8_t i,j;
552 for (i=0;i<NumOfLeds;i++)
553 {
554 for (j=0;j<NumOfLeds-i;j++)
555 {
556 changeled(color,lightdata,j); //running LED, foreground
557 if (j>0)
558 {
559 changeled(backcolor,lightdata,j-1); //background LEDs
560 }
561 transmit2leds(lightdata);
562 effectdelay(effectime);
563 }
564 if (PacketComplete==1)
565 break;
566 effectdelay(effectime);
567 }
568 }

LedEffects.h File Reference
AAAAAAAAARAAAAAAAAAR
file that contains different effect definitions for the lightstribe
#include <stdint.h>

Macros
#define SETFULLCOLOR 0AAAAAAAACTAAAAAAAACT

define for the setfullcolor effect, used for main switch
#define FILLUP 1AAAAAAAACUAAAAAAAACU

define for the the fillup effect, used for main switch
#define BLINK 2AAAAAAAACVAAAAAAAACV

define for the blink effect, used for main switch
#define RUNLED 3AAAAAAAACWAAAAAAAACW

define for the runled effect, used for main switch, refers to the runled init
#define ALTERNATE 5AAAAAAAACXAAAAAAAACX

define for the alternating effect, used for main switch, refers to the alternate init
#define RECOLOR 7AAAAAAAACYAAAAAAAACY

define for the recolor effect, used for main switch
#define FADE 8AAAAAAAACZAAAAAAAACZ

define for the fade effect, used for main switch
#define INITRAINBOW 9AAAAAAAADAAAAAAAAADA

define for the initrainbow function, used for main switch
#define ROTATE_R 10AAAAAAAADBAAAAAAAADB

define for the the rotate function right, used for main switch
#define ROTATE_L 11AAAAAAAADCAAAAAAAADC

define for the the rotate function left, used for main switch
#define CUSTOM 12AAAAAAAADDAAAAAAAADD

define for the custom effect, used for main switch, every LED is filled in a userdefined color (up to MAXNUMCOLORS, then reloop the colors)
#define EASTEREGG 13AAAAAAAADEAAAAAAAADE

define for the easteregg effect, used for main switch
Functions
uint8_t map (uint8_t x, uint8_t in_min, uint8_t in_max, uint8_t out_min, uint8_t out_max)
Arduino map function; used for color conversion.
struct color24bit colorconv8to24 (uint8_t startcolor)
color conversion function; converts a 8 Bit color (RGB 3-3-2) to a 24 Bit color (RGB 8-8-8)
void effectdelay (uint16_t delay)
simple delay function; no concrete delay time
void setfullcolor (struct color24bit color, uint8_t *lightdata)
Set all LEDs to the chosen color; run transmit2leds afterwards to update the LEDs.
void resetstribe (uint8_t *lightdata)
Set all LEDs off; run transmit2leds afterwards to update the LEDs.
void rotate (uint8_t *lightdata, uint8_t direction)
Rotate the lightdata for 1 LED Position; run transmit2leds afterwards to update the LEDs.
void rotateN (uint8_t *lightdata, uint8_t direction, uint8_t width)
Rotate the lightdata for n LED Positions; run transmit2leds afterwards to update the LEDs.
void initrunled (struct color24bit color, uint8_t *lightdata, struct color24bit background)
init the runled effect; run runrunled afterwards to start the effect
void runrunled (uint8_t *lightdata, uint8_t direction)
Do the runled effect; before this function is called the lightdata needs to be initiliazed using initrunled!
void blinkled (struct color24bit color, uint8_t *lightdata)
blink the whole stribe; this function does not need another function call
void init_alternating (struct color24bit color, struct color24bit backcolor, uint8_t *lightdata)
initialize the alternating function; call run_alternating afterwards
void run_alternating (uint8_t *lightdata)
Run the alternating effect; call init_alternating before.
void recolor (struct color24bit color, uint8_t *lightdata)
Recolor the LED stribe; no other function call is necessary.
void faden (struct color24bit color, uint8_t *lightdata)
Generate a fading color effect. No other function call is necessary.
void initrainbow (uint8_t *lightdata)
Initialize a rainbow on the color array; to show the rainbow run transmit2leds afterwards.
void eastereggbase (struct color24bit color, uint8_t *lightdata)
Initialize the easteregg; do not use directly; this function is used by the easteregg function.
void easteregg (uint8_t *lightdata)
Run the easteregg; No other function call is necessary.
void fillup (struct color24bit color, struct color24bit backcolor, uint8_t *lightdata)
This function fills up the stribe; No other function call is necessary.

Detailed Description
file that contains different effect definitions for the lightstribe

Version:
V1.00
Date:
05.01.2016
Authors:
Wank Florian
Definition in file LedEffects.h.

Function Documentation
void blinkled (struct color24bit color, uint8_t * lightdata)
AAAAAAAABZAAAAAAAABZ
blink the whole stribe; this function does not need another function call
This function creates a blinking effect. First all LEDs are set to the chosen color, after the defined delay the LEDs are turned off. This is repeated in the main while loop.
Parameters:
in | struct | color24bit color : color for the blink effect
in | uint8_t | *lightdata : lightdata array that holds the color values for the stribe
Returns: void
Note:
No need to run transmit2leds afterwards! This is already done in the function.
Definition at line 278 of file LedEffects.c.
References effectdelay()effectdelay(), effectimeeffectime, resetstribe()resetstribe(), setfullcolor()setfullcolor(), and transmit2leds()transmit2leds().
Referenced by main()main().
struct color24bit colorconv8to24 (uint8_t startcolor)
AAAAAAAABRAAAAAAAABR
color conversion function; converts a 8 Bit color (RGB 3-3-2) to a 24 Bit color (RGB 8-8-8)

Parameters:
in | uint8_t | startcolor: 8 Bit color to convert
Returns: struct color24bit : 24 Bit color result
Note:
This function converts the 8 Bit color to a 24 Bit color depending on the ledtype. This is neccessary because of differnt color formats (WS2811->RGB ; WS2812->GRB). Original the whole environment was for WS2812 LEDs!
Definition at line 45 of file LedEffects.c.
References color24bit::bluecolor24bit::blue, color24bit::greencolor24bit::green, ledtypeledtype, map()map(), and color24bit::redcolor24bit::red.
Referenced by easteregg()easteregg(), and main()main().
void easteregg (uint8_t * lightdata)
AAAAAAAACGAAAAAAAACG
Run the easteregg; No other function call is necessary.

Parameters:
in | uint8_t | *lightdata : lightdata array that holds the color values for the stribe
Returns: void
Note:
Just try it :-) funny looking effect
Definition at line 514 of file LedEffects.c.
References colorconv8to24()colorconv8to24(), eastereggbase()eastereggbase(), and PacketCompletePacketComplete.
Referenced by main()main().
void eastereggbase (struct color24bit color, uint8_t * lightdata)
AAAAAAAACFAAAAAAAACF
Initialize the easteregg; do not use directly; this function is used by the easteregg function.

Parameters:
in | struct | color24bit color : color for the easteregg
in | uint8_t | *lightdata : lightdata array that holds the color values for the stribe
Returns: void
Note:
Do not use this function directly; this function is used by the easteregg function
Definition at line 489 of file LedEffects.c.
References changeled()changeled(), effectdelay()effectdelay(), effectimeeffectime, NumOfLedsNumOfLeds, PacketCompletePacketComplete, rotate()rotate(), and transmit2leds()transmit2leds().
Referenced by easteregg()easteregg().
void effectdelay (uint16_t delay)
AAAAAAAABSAAAAAAAABS
simple delay function; no concrete delay time

Parameters:
in | uint16_t | delay : delay value
Returns: void
Note:
This function is just a variable delay, there is no coherence with a concrete time (i.e. s, ms)
Definition at line 72 of file LedEffects.c.
References PacketCompletePacketComplete.
Referenced by blinkled()blinkled(), eastereggbase()eastereggbase(), faden()faden(), fillup()fillup(), main()main(), recolor()recolor(), run_alternating()run_alternating(), and runrunled()runrunled().
void faden (struct color24bit color, uint8_t * lightdata)
AAAAAAAACDAAAAAAAACD
Generate a fading color effect. No other function call is necessary.
This function generates a fading color effect. At the beginning the whole stribe is filled with the chosen color. The color intensity of each color channel (blue, red, green) is decreased until the stribe is off. After that the color values are increased until the chosen color values are reached. The effect looks different depending on the chosen color because the color value proportion is not kept over the whole effect.
Parameters:
in | struct | color24bit color : color that is used for the fading effect
in | uint8_t | *lightdata : lightdata array that holds the color values for the stribe
Returns: void
Note:
No need to run transmit2leds afterwards! The effect is standalone and ends is looped in the main while loop. The color value proportion is not kept over the whole effect.
Definition at line 366 of file LedEffects.c.
References color24bit::bluecolor24bit::blue, effectdelay()effectdelay(), effectimeeffectime, color24bit::greencolor24bit::green, PacketCompletePacketComplete, color24bit::redcolor24bit::red, setfullcolor()setfullcolor(), and transmit2leds()transmit2leds().
Referenced by main()main().
void fillup (struct color24bit color, struct color24bit backcolor, uint8_t * lightdata)
AAAAAAAACHAAAAAAAACH
This function fills up the stribe; No other function call is necessary.
This function fills up the whole stribe and beginns again if it is finished. First one LED moves in the chosen color stepwise through the whole stribe and recolors all LEDs in the background color which have already been passed. At the end of the stribe the LED stays an the next single LED is going to move to the last-1 position. The next LED to the last-2 position. This is going on until the whole stribe is colored. Then the effect restarts (main while loop).
Parameters:
in | struct | color24bit color : foreground color for the moving LED
in | struct | color24bit backcolor : background color
in | uint8_t | *lightdata : lightdata array that holds the color values for the stribe
Returns: void
Note:
This is a standalone effect.
Definition at line 549 of file LedEffects.c.
References changeled()changeled(), effectdelay()effectdelay(), effectimeeffectime, NumOfLedsNumOfLeds, PacketCompletePacketComplete, and transmit2leds()transmit2leds().
Referenced by main()main().
void init_alternating (struct color24bit color, struct color24bit backcolor, uint8_t * lightdata)
AAAAAAAACAAAAAAAAACA
initialize the alternating function; call run_alternating afterwards
This function initializes the alternating effect. The effect assigns every even LED number in one color and the odd numbers in the background color. If the effect is running, the odd and even LED switch positions.
Parameters:
in | struct | color24bit color : color for the alternate effect (Init even LEDs)
in | struct | color24bit backcolor : color for the alternate effect bakckground (Init odd LEDs)
in | uint8_t | *lightdata : lightdata array that holds the color values for the stribe
Returns: void
Note:
Run run_alternating afterwards to start the effect!
Definition at line 300 of file LedEffects.c.
References changeled()changeled(), NumOfLedsNumOfLeds, and setfullcolor()setfullcolor().
Referenced by main()main().
void initrainbow (uint8_t * lightdata)
AAAAAAAACEAAAAAAAACE
Initialize a rainbow on the color array; to show the rainbow run transmit2leds afterwards.
This function fills the color array with rainbow colors. For this effect the color array is filled with different colors that are calculated by increasing and decreasing the color channels to loop over a RGB palette.
Parameters:
in | uint8_t | *lightdata : lightdata array that holds the color values for the stribe
Returns: void
Note:
Run transmit2leds afterwards! A nice effect is to rotate the array stepwise after the rainbow initialization (run transmit2leds after every rotation). The effect directly sets color values, so there may be a problem with the color profiles (RGB vs. GRB). The function was primary written for WS2812 LEDs (GRB)! The effect needs a minimum number of 20 LEDs to look nice!
Definition at line 442 of file LedEffects.c.
References color24bit::bluecolor24bit::blue, changeled()changeled(), color24bit::greencolor24bit::green, NumOfLedsNumOfLeds, and color24bit::redcolor24bit::red.
Referenced by main()main().
void initrunled (struct color24bit color, uint8_t * lightdata, struct color24bit background)
AAAAAAAABXAAAAAAAABX
init the runled effect; run runrunled afterwards to start the effect
This function initializes the running LED effect. The running LED effect has a background color that is used for all LEDs except one. One LED is in the foreground color an moves stepwise along the stribe. The initialization prepares the lightdata array by setting one LED at the start position and filling the others with the background color.
Parameters:
in | struct | color24bit color : 24 Bit color for the effect
in | uint8_t | *lightdata : lightdata array that holds the color values for the stribe
in | struct | color24bit background : 24 Bit color for the effect background
Returns: void
Note:
Run runrunled afterwards to start the effect!
Definition at line 217 of file LedEffects.c.
References changeled()changeled(), and setfullcolor()setfullcolor().
Referenced by main()main().
uint8_t map (uint8_t x, uint8_t in_min, uint8_t in_max, uint8_t out_min, uint8_t out_max)
AAAAAAAABQAAAAAAAABQ
Arduino map function; used for color conversion.

Parameters:
in | uint8_t | x: value to map
in | uint8_t | in_min : minimum value input reference
in | uint8_t | in_max : maximum value input reference
in | uint8_t | out_min : minimum value output reference
in | uint8_t | out_max : maximum value output reference
Returns: uint8_t : mapped value referring to the input
Note:
This function is used for color conversion from 8 Bit to 24 Bit colors; How it works: in_min < x < in_max convert to out_min < returnvalue < out_max by positioning the x proportionally in the new number range
Definition at line 33 of file LedEffects.c.
Referenced by colorconv8to24()colorconv8to24().
void recolor (struct color24bit color, uint8_t * lightdata)
AAAAAAAACCAAAAAAAACC
Recolor the LED stribe; no other function call is necessary.
This function generates a recolor effect. The old configuration of the LEDs is overwritten with the new color step by step. When the whole stribe is filled with the new color the effect ends.
Parameters:
in | struct | color24bit color : color that is used for recoloring
in | uint8_t | *lightdata : lightdata array that holds the color values for the stribe
Returns: void
Note:
No need to run transmit2leds afterwards! The effect is standalone and ends if the stribe is recolored.
Definition at line 340 of file LedEffects.c.
References changeled()changeled(), effectdelay()effectdelay(), effectimeeffectime, NumOfLedsNumOfLeds, PacketCompletePacketComplete, and transmit2leds()transmit2leds().
Referenced by main()main().
void resetstribe (uint8_t * lightdata)
AAAAAAAABUAAAAAAAABU
Set all LEDs off; run transmit2leds afterwards to update the LEDs.

Parameters:
in | uint8_t | *lightdata : lightdata array that holds the color values for the stribe
Returns: void
Note:
This function sets the lightdata array to 0x00. To update the stribe run transmit2leds afterwards!
Definition at line 118 of file LedEffects.c.
References color24bit::bluecolor24bit::blue, color24bit::greencolor24bit::green, color24bit::redcolor24bit::red, and setfullcolor()setfullcolor().
Referenced by blinkled()blinkled().
void rotate (uint8_t * lightdata, uint8_t direction)
AAAAAAAABVAAAAAAAABV
Rotate the lightdata for 1 LED Position; run transmit2leds afterwards to update the LEDs.

Parameters:
in | uint8_t | *lightdata : lightdata array that holds the color values for the stribe
in | uint8_t | direction : direction to rotate
Returns: void
Note:
This function rotates lightdata array. To update the stribe run transmit2leds afterwards! The rotation "moves every LED" by one step, the overflowing LED is appended at the other ending. Example: RED BLUE YELLOW GREEN ... rotate... BLUE YELLOW GREEN RED other direction: RED BLUE YELLOW GREEN ... rotate... GREEN RED BLUE YELLOW
Definition at line 138 of file LedEffects.c.
References NumOfLedsNumOfLeds.
Referenced by eastereggbase()eastereggbase(), main()main(), rotateN()rotateN(), run_alternating()run_alternating(), and runrunled()runrunled().
void rotateN (uint8_t * lightdata, uint8_t direction, uint8_t width)
AAAAAAAABWAAAAAAAABW
Rotate the lightdata for n LED Positions; run transmit2leds afterwards to update the LEDs.

Parameters:
in | uint8_t | *lightdata : lightdata array that holds the color values for the stribe
in | uint8_t | direction : direction to rotate
in | uint8_t | width : width to rotate
Returns: void
Note:
This function rotates lightdata array. To update the stribe run transmit2leds afterwards! The rotation "moves every LED" by n steps, the overflowing LEDs are appended at the other ending. Example: RED BLUE YELLOW GREEN PINK ... rotate 2 ... YELLOW GREEN PINK RED BLUE other direction: RED BLUE YELLOW GREEN PINK ... rotate 2 ... GREEN PINK RED BLUE YELLOW
Definition at line 196 of file LedEffects.c.
References rotate()rotate().
void run_alternating (uint8_t * lightdata)
AAAAAAAACBAAAAAAAACB
Run the alternating effect; call init_alternating before.
This function runs the alternating effect. The effect assigns every even LED number in one color and the odd numbers in the background color. If the effect is running, the odd and even LED switch positions. This function rotates the LEDs by one position to achieve the effect. The rotation direction is not of importance.
Parameters:
in | uint8_t | *lightdata : lightdata array that holds the color values for the stribe
Returns: void
Note:
No need to run transmit2leds afterwards! The effect is generated by the main while loop.
Definition at line 323 of file LedEffects.c.
References effectdelay()effectdelay(), effectimeeffectime, rotate()rotate(), and transmit2leds()transmit2leds().
Referenced by main()main().
void runrunled (uint8_t * lightdata, uint8_t direction)
AAAAAAAABYAAAAAAAABY
Do the runled effect; before this function is called the lightdata needs to be initiliazed using initrunled!
This function runs the running LED effect. The running LED effect has a background color that is used for all LEDs except one. The one LED moves stepwise to the next position depending on the chosen direction. Direction 0/1 are right/left, direction 2 runs from left to right an back again. For direction 0/1 the running LED overflows and begins on the other ending.
Parameters:
in | uint8_t | *lightdata : lightdata array that holds the color values for the stribe
in | uint8_t | direction : movement direction, 0/1 = right/left, 2 = left->right and back
Returns: void
Note:
No need to run transmit2leds afterwards! This is already done in the function. The function is interrupted if a new UART package is completely received so a new effect gets active.
Definition at line 236 of file LedEffects.c.
References effectdelay()effectdelay(), effectimeeffectime, NumOfLedsNumOfLeds, PacketCompletePacketComplete, rotate()rotate(), and transmit2leds()transmit2leds().
Referenced by main()main().
void setfullcolor (struct color24bit color, uint8_t * lightdata)
AAAAAAAABTAAAAAAAABT
Set all LEDs to the chosen color; run transmit2leds afterwards to update the LEDs.

Parameters:
in | struct | color24bit color : color to set
in | uint8_t | *lightdata : lightdata array that holds the color values for the stribe
Returns: void
Note:
This function sets the lightdata array. To update the stribe run transmit2leds afterwards!
Definition at line 96 of file LedEffects.c.
References color24bit::bluecolor24bit::blue, color24bit::greencolor24bit::green, NumOfLedsNumOfLeds, and color24bit::redcolor24bit::red.
Referenced by blinkled()blinkled(), faden()faden(), init_alternating()init_alternating(), initrunled()initrunled(), main()main(), and resetstribe()resetstribe().

LedEffects.h
1 /**************************************************************************/
9 #include <stdint.h>
10
11 #ifndef LEDEFFECTS_H_
12 #define LEDEFFECTS_H_
13
14 //EFFECTS
16 #define SETFULLCOLOR 0
17
18 #define FILLUP 1
19
20 #define BLINK 2
21
22 #define RUNLED 3
23
24 #define ALTERNATE 5
25
26 #define RECOLOR 7
27
28 #define FADE 8
29
30 #define INITRAINBOW 9
31
32 #define ROTATE_R 10
33
34 #define ROTATE_L 11
35
36 #define CUSTOM 12
37
38 #define EASTEREGG 13
39
40 uint8_t map(uint8_t x, uint8_t in_min, uint8_t in_max, uint8_t out_min, uint8_t out_max); //Map function for color conversion; calcualates a value in a new number range
41 struct color24bit colorconv8to24(uint8_t startcolor); //Convert a 8 Bit color (RGB 3-3-2) to 24 Bit color (RGB 8-8-8); color assignment depends on the ledtype
42 void effectdelay(uint16_t delay); //a simple variable delay function
43 void setfullcolor(struct color24bit color, uint8_t *lightdata); //set the whole stribe in one color, call transmit2leds afterwards
44 void resetstribe(uint8_t *lightdata); //set the whole stribe off, call transmit2leds afterwards
45 void rotate(uint8_t *lightdata, uint8_t direction); //rotate the color array by one position
46 void rotateN(uint8_t *lightdata, uint8_t direction, uint8_t width); //rotate the color array by n positions
47 void initrunled(struct color24bit color, uint8_t *lightdata, struct color24bit background); //initialize the runled effect, call runrunled afterwards
48 void runrunled(uint8_t *lightdata, uint8_t direction); //runs the runled effect, call initrunled before
49 void blinkled(struct color24bit color, uint8_t *lightdata); //generate a blinking effect
50 void init_alternating(struct color24bit color, struct color24bit backcolor, uint8_t *lightdata);//initialize the alternating effect, call run_alternating afterwards
51 void run_alternating(uint8_t *lightdata ); //run the alternating effect, call init_alternating before
52 void recolor(struct color24bit color, uint8_t *lightdata); //recolor the stribe step by step, stand alone function, ends after execution
53 void faden(struct color24bit color, uint8_t *lightdata); //color fading effect, stand alone effect
54 void initrainbow(uint8_t *lightdata); //init the stribe with rainbow colors, call transmit2leds afterwards
55 void eastereggbase(struct color24bit color, uint8_t *lightdata); //part of the easteregg effect, do not call directly
56 void easteregg(uint8_t *lightdata); //easteregg effect, try out and have fun :-)
57 void fillup(struct color24bit color,struct color24bit backcolor, uint8_t *lightdata); //fill the stribe step by step until the stribe has one color, the background color is filled behind
58
59 #endif /* LEDEFFECTS_H_ */

Lightstribe.c File Reference
AAAAAAAAESAAAAAAAAES
basic functions for controlling WS2811/WS2812 LEDs
#include "globals.h"

#include "Lightstribe.h"

#include <util/delay.h>

Functions
void changeled (struct color24bit color, uint8_t *lightdata, uint8_t lednr)
change the color of one LED at a specific position; run transmit2leds afterwards to update the LEDs
void setled (struct color24bit color, uint8_t *lightdata, uint8_t lednr)
set the color of one LED at a specific position, all others are off; run transmit2leds afterwards to update the LEDs
void transmit2leds (uint8_t lightdata[])
transmit the color array to the stribe

Detailed Description
basic functions for controlling WS2811/WS2812 LEDs
This file contains the basic functions to control WS2811/WS2812 LEDs using an AVR. It declares the function to transmit lightdata to a stribe using the one wire protocol. For the right timing be aware of the crystal frequency! This code is written for using an extern clock of 16 MHz, if you change it you need to modify the number of NOPs in the macros defined in the header file. This file also contains the basic functions to set or to change one LED in the stribe. The whole system is working with a color array that stores the 24 Bit colors for all LEDs in an GRB format (WS2812). Every effect changes the array, after that the array is sent out by the transmit2leds function. This guarantees a correct timing. The most functions base on uint8_t variables so the maximum length of the stribe to control contains 255 LEDs. This should not be changed because you have hardware limitations as well that will limit a basic setup to 200-250 LEDs.
Version:
V1.00
Date:
05.01.2016
Authors:
Wank Florian
Definition in file Lightstribe.c.

Function Documentation
void changeled (struct color24bit color, uint8_t * lightdata, uint8_t lednr)
AAAAAAAABEAAAAAAAABE
change the color of one LED at a specific position; run transmit2leds afterwards to update the LEDs

Parameters:
in | struct | color24bit color : 24 bit color in GRB format
in | uint8_t | *lightdata : pointer to the complete lightdata that contains all color values
in | uint8_t | lednr : position of the LED that should be changed
Returns: void
Note:
the right color format is created using the colorconv8to24-function with the ledtype predefined
Definition at line 33 of file Lightstribe.c.
References color24bit::bluecolor24bit::blue, color24bit::greencolor24bit::green, NumOfLedsNumOfLeds, and color24bit::redcolor24bit::red.
Referenced by eastereggbase()eastereggbase(), fillup()fillup(), init_alternating()init_alternating(), initrainbow()initrainbow(), initrunled()initrunled(), main()main(), and recolor()recolor().
void setled (struct color24bit color, uint8_t * lightdata, uint8_t lednr)
AAAAAAAACIAAAAAAAACI
set the color of one LED at a specific position, all others are off; run transmit2leds afterwards to update the LEDs

Parameters:
in | struct | color24bit color : 24 bit color in GRB format
in | uint8_t | *lightdata : pointer to the complete lightdata that contains all color values
in | uint8_t | lednr : position of the LED that should be set
Returns: void
Note:
the right color format is created using the colorconv8to24-function with the ledtype predefined; all other LEDs are cleared so they are off
Definition at line 51 of file Lightstribe.c.
References color24bit::bluecolor24bit::blue, color24bit::greencolor24bit::green, NumOfLedsNumOfLeds, and color24bit::redcolor24bit::red.
void transmit2leds (uint8_t lightdata[])
AAAAAAAABGAAAAAAAABG
transmit the color array to the stribe
To control the LEDs of type WS2811/WS2812 a critical timing is necessary. To achieve the correct timing and to create effects the lightdata is stored in an array first. All operations effect the color array. If the color array is prepared it is transmitted to the stribes via a one-wire protocol using this function. This function generates the high and low times using assembler NOPs to achieve the timing. The number of NOPs are stored in macros for transmitting a Low Bit (SETLOW) or a High Bit (SETHIGH). This function should not be changed or optimized because of the timing!
Parameters:
in | uint8_t | lightdata[] : data with the colors for each LED to control
Returns: void
Note:
This function should not be changed or optimized because of the timing! Do not use higher optimization than O1!!! Do not remove the {} brackets because SETLOW/SETHIGH are definitions with several commands!
Definition at line 96 of file Lightstribe.c.
References NumOfLedsNumOfLeds.
Referenced by blinkled()blinkled(), eastereggbase()eastereggbase(), faden()faden(), fillup()fillup(), main()main(), recolor()recolor(), run_alternating()run_alternating(), and runrunled()runrunled().

Lightstribe.c
1 /**************************************************************************/
22 #include "globals.h"
23 #include "Lightstribe.h"
24 #include <util/delay.h>
25
33 void changeled(struct color24bit color, uint8_t *lightdata, uint8_t lednr)
34 {
35 if (lednr>NumOfLeds)
36 return;
37 lightdata=lightdata+lednr*3;
38 *lightdata++=color.green;
39 *lightdata++=color.red;
40 *lightdata++=color.blue;
41 }
42
51 void setled(struct color24bit color, uint8_t *lightdata, uint8_t lednr)
52 {
53 uint8_t ledcolor;
54 uint16_t i;
55 if (lednr>NumOfLeds)
56 return;
57 //Loop over the whole color array (-->NumOfLeds*3)
58 for (i=0;i<NumOfLeds*3;i++)
59 {
60 if (i==(lednr*3) || i==(lednr*3+1) || i==(lednr*3+2))
61 { //position of the LED to set
62 ledcolor = i%3;
63 if (ledcolor==0)
64 *lightdata++=color.green;
65 else if(ledcolor==1)
66 *lightdata++=color.red;
67 else
68 *lightdata++=color.blue;
69 }
70 else
71 { //all others off (0x00-->black)
72 ledcolor = i%3;
73 if (ledcolor==0)
74 *lightdata++=0x00;
75 else if(ledcolor==1)
76 *lightdata++=0x00;
77 else
78 *lightdata++=0x00;
79 }
80 }
81 }
82
96 void transmit2leds(uint8_t lightdata[])
97 {
98 uint16_t i ;
99 uint8_t byte2send ;
100 for(i=0;i<NumOfLeds*3;i++)
101 {
102 byte2send = lightdata[i];
103 //Transmit each Bit of one Byte using the One Wire Protocoll
104 if ((byte2send & 128)==0)
105 {
106 SETLOW
107 }
108 else
109 {
110 SETHIGH
111 }
112 if ((byte2send & 64)==0)
113 {
114 SETLOW
115 }
116 else
117 {
118 SETHIGH
119 }
120 if ((byte2send & 32)==0)
121 {
122 SETLOW
123 }
124 else
125 {
126 SETHIGH
127 }
128 if ((byte2send & 16)==0)
129 {
130 SETLOW
131 }
132 else
133 {
134 SETHIGH
135 }
136 if ((byte2send & 8)==0)
137 {
138 SETLOW
139 }
140 else
141 {
142 SETHIGH
143 }
144 if ((byte2send & 4)==0)
145 {
146 SETLOW
147 }
148 else
149 {
150 SETHIGH
151 }
152 if ((byte2send & 2)==0)
153 {
154 SETLOW
155 }
156 else
157 {
158 SETHIGH
159 }
160 if ((byte2send & 1)==0)
161 {
162 SETLOW
163 }
164 else
165 {
166 SETHIGH
167 }
168 }
169 _delay_us(55); //defined delay after the transmission is complete (Datasheet says >=50us)
170 }

Lightstribe.h File Reference
AAAAAAAAAQAAAAAAAAAQ
basic functions for controlling WS2811/WS2812 LEDs
#include <stdint.h>

#include <avr/io.h>

Data Structures
struct color24bit
24 Bit color structure RGB 8-8-8 Functions
void changeled (struct color24bit color, uint8_t *lightdata, uint8_t lednr)
change the color of one LED at a specific position; run transmit2leds afterwards to update the LEDs
void setled (struct color24bit color, uint8_t *lightdata, uint8_t lednr)
set the color of one LED at a specific position, all others are off; run transmit2leds afterwards to update the LEDs
void transmit2leds (uint8_t lightdata[])
transmit the color array to the stribe

Detailed Description
basic functions for controlling WS2811/WS2812 LEDs

Version:
V1.00
Date:
05.01.2016
Authors:
Wank Florian
Definition in file Lightstribe.h.

Function Documentation
void changeled (struct color24bit color, uint8_t * lightdata, uint8_t lednr)
AAAAAAAACJAAAAAAAACJ
change the color of one LED at a specific position; run transmit2leds afterwards to update the LEDs

Parameters:
in | struct | color24bit color : 24 bit color in GRB format
in | uint8_t | *lightdata : pointer to the complete lightdata that contains all color values
in | uint8_t | lednr : position of the LED that should be changed
Returns: void
Note:
the right color format is created using the colorconv8to24-function with the ledtype predefined
Definition at line 33 of file Lightstribe.c.
References color24bit::bluecolor24bit::blue, color24bit::greencolor24bit::green, NumOfLedsNumOfLeds, and color24bit::redcolor24bit::red.
Referenced by eastereggbase()eastereggbase(), fillup()fillup(), init_alternating()init_alternating(), initrainbow()initrainbow(), initrunled()initrunled(), main()main(), and recolor()recolor().
void setled (struct color24bit color, uint8_t * lightdata, uint8_t lednr)
AAAAAAAACKAAAAAAAACK
set the color of one LED at a specific position, all others are off; run transmit2leds afterwards to update the LEDs

Parameters:
in | struct | color24bit color : 24 bit color in GRB format
in | uint8_t | *lightdata : pointer to the complete lightdata that contains all color values
in | uint8_t | lednr : position of the LED that should be set
Returns: void
Note:
the right color format is created using the colorconv8to24-function with the ledtype predefined; all other LEDs are cleared so they are off
Definition at line 51 of file Lightstribe.c.
References color24bit::bluecolor24bit::blue, color24bit::greencolor24bit::green, NumOfLedsNumOfLeds, and color24bit::redcolor24bit::red.
void transmit2leds (uint8_t lightdata[])
AAAAAAAACLAAAAAAAACL
transmit the color array to the stribe
To control the LEDs of type WS2811/WS2812 a critical timing is necessary. To achieve the correct timing and to create effects the lightdata is stored in an array first. All operations effect the color array. If the color array is prepared it is transmitted to the stribes via a one-wire protocol using this function. This function generates the high and low times using assembler NOPs to achieve the timing. The number of NOPs are stored in macros for transmitting a Low Bit (SETLOW) or a High Bit (SETHIGH). This function should not be changed or optimized because of the timing!
Parameters:
in | uint8_t | lightdata[] : data with the colors for each LED to control
Returns: void
Note:
This function should not be changed or optimized because of the timing! Do not use higher optimization than O1!!! Do not remove the {} brackets because SETLOW/SETHIGH are definitions with several commands!
Definition at line 96 of file Lightstribe.c.
References NumOfLedsNumOfLeds.
Referenced by blinkled()blinkled(), eastereggbase()eastereggbase(), faden()faden(), fillup()fillup(), main()main(), recolor()recolor(), run_alternating()run_alternating(), and runrunled()runrunled().

Lightstribe.h
1 /**************************************************************************/
9 #include <stdint.h>
10 #include <avr/io.h>
11
12 #ifndef LIGHTSTRIBE_H_
13 #define LIGHTSTRIBE_H_
14
16 struct color24bit{
18 uint8_t red;
20 uint8_t green;
22 uint8_t blue;
23 };
24
25 #if F_CPU == 16000000
26 #pragma message("Use 16 MHz Macros")
27
28 #define SETHIGH PORTB=0x01;\
29 asm ("nop");\
30 asm ("nop");\
31 asm ("nop");\
32 asm ("nop");\
33 asm ("nop");\
34 asm ("nop");\
35 asm ("nop");\
36 asm ("nop");\
37 asm ("nop");\
38 asm ("nop");\
39 asm ("nop");\
40 PORTB=0x00;\
41 asm ("nop");\
42 asm ("nop");\
43 asm ("nop");
44
45 #elif F_CPU == 8000000
46 #pragma message("Use 8 MHz Macros")
47
48 #define SETHIGH PORTB=0x01;\
49 asm ("nop");\
50 asm ("nop");\
51 asm ("nop");\
52 asm ("nop");\
53 asm ("nop");\
54 PORTB=0x00;\
55 asm ("nop");\
56 asm ("nop");
57 #endif
58
59
60
61 #if F_CPU == 16000000
62
63 #define SETLOW PORTB=0x01;\
64 asm ("nop");\
65 asm ("nop");\
66 asm ("nop");\
67 asm ("nop");\
68 asm ("nop");\
69 PORTB=0x00;\
70 asm ("nop");\
71 asm ("nop");\
72 asm ("nop");\
73 asm ("nop");\
74 asm ("nop");\
75 asm ("nop");\
76 asm ("nop");\
77 asm ("nop");\
78 asm ("nop");
79 #elif F_CPU == 8000000
80
81 #define SETLOW PORTB=0x01;\
82 asm ("nop");\
83 asm ("nop");\
84 PORTB=0x00;\
85 asm ("nop");\
86 asm ("nop");\
87 asm ("nop");
88 #endif
89
90
91 //function to change one LED at a specific position; all other LEDs are not changed; run transmit2leds afterwards
92 void changeled(struct color24bit color, uint8_t *lightdata, uint8_t lednr);
93 //function to set one LED at a specific position; all other LEDs are turned off; run transmit2leds afterwards
94 void setled(struct color24bit color, uint8_t *lightdata, uint8_t lednr);
95 //transmit the color array to the stribe --> one wire data transmission
96 void transmit2leds(uint8_t lightdata[]);
97
98 #endif /* LIGHTSTRIBE_H_ */

ws2811lichterkette.c File Reference
AAAAAAAAEWAAAAAAAAEW
main file for interfacing WS2811/WS2812 LEDs
#include "globals.h"

#include <avr/io.h>

#include <util/delay.h>

#include <avr/interrupt.h>

#include <stdio.h>

#include <stdlib.h>

#include <string.h>

#include "Lightstribe.h"

#include "LedEffects.h"

Macros
#define EXTERNAAAAAAAAEXAAAAAAAAEX

#define BAUD 38400AAAAAAAAEYAAAAAAAAEY

Baudrate definition, choose 76800 or 38400, faster value preferred, the maximum speed of ESP8266 software-UART is 38400.
#define MYUBRR F_CPU/16/BAUD -1AAAAAAAACNAAAAAAAACN

calculate baudrate register value
#define BAUD_REAL (F_CPU/(16*(MYUBRR+1))) /*real baudrate in this configuration*/AAAAAAAAEZAAAAAAAAEZ

#define BAUD_ERROR ((BAUD_REAL*1000)/BAUD) /*calculate baudrate error*/AAAAAAAAFAAAAAAAAAFA

#define PREAMBLE 254AAAAAAAADGAAAAAAAADG

definition of the preamble is 254, no other data field must contain this value
#define LENINDEX 1AAAAAAAADHAAAAAAAADH

definition of the second field; contains the total packet length (including the preamble)
#define EFFECTINDEX 2AAAAAAAACQAAAAAAAACQ

definition of 1 Byte effect at third position, the MSBit is used to choose WS2811/WS2812 (color profile RGB or GRB)
#define DELAYINDEX 3AAAAAAAACRAAAAAAAACR

definition of the delay field, contains the delay duplicator
#define NUMOFLEDINDEX 4AAAAAAAACSAAAAAAAACS

field position for the number of LEDs to control
Functions
void init_uart (void)
Init the hardware UART with Baud = 76800/38400, depending on BAUD definition, 8 Databits, 1 Stopbit, no Parity.
int main (void)AAAAAAAACOAAAAAAAACO
main function, should never end, effects are handled in main while
ISR (USART_RX_vect)AAAAAAAADFAAAAAAAADF
UART Interrupt handler, interrupts when new data is available in the RX buffer.

Detailed Description
main file for interfacing WS2811/WS2812 LEDs
This file contains the main environment for interfacing WS2811/WS2812 LEDs with an AVR. The implementation has been done for an atmega328p. You may use another controller but be aware of the memory you need for the color array (dynamically allocated). The AVR interfaces the one wire of the LEDs. All operations (effects, colorchange etc.) are done on an lightdata array, that needs to be transmitted to the LEDs after your operations. The reason for this is the critical timing for interfacing the LEDs. So also be aware if you change the clock speed. If you do so you have to change the number of NOPs in the macros of Lightstribe.h. Because of the critical timing compile all files at optimization O1! Furthermore be aware of the BAUDRATE changes, the BAUD error may be to worse if you change the CPU frequency.
The one wire output is on the PIN B0! You can change in the main and Lightstribe.h.
By default this file just initializes the AVR system, no updates to the LEDs are done by default. To change the LED configuration you need to access the AVR UART Interface with another controller (FTDI is also possible). Over the UART you send a message containing all relevant information for the system. Therefore a simple protocol is used: 1 Byte preamble (254) 1 Byte total packet length (including the preamble) 1 Byte effect 1 Byte effect delay (effect speed) 1 Byte number of LEDs to control n Bytes containing 8-Bit color values (RGB 3-3-2), depended on the effect, max. 50 values The preamble 254 must never be used at another position!!!
Protocol examples:
SETFULLCOLOR: 254 6 0 1 20 22
FILLUP: 254 7 1 22 20 22 201
BLINK: 254 6 2 55 20 56
RUNLED: 254 7 3 55 20 56 151
INITRAINBOW: 254 5 9 0 20
ROTATE_R: 254 5 11 23 20
CUSTOM: 254 8 12 1 20 22 201 60
EASTEREGG: 254 5 13 2 20
The UART communication is done by using an RX interrupt an storing the data into a temp array. In the main loop a flag shows if a data packet is complete. So you will get no update on the LEDs if the UART package was wrong (too short). In the project this programm has been written the UART was controlled by an ESP8266 or BLE113. Have Fun!
Version:
V1.00
Date:
05.01.2016
Authors:
Wank Florian
Definition in file ws2811lichterkette.c.

Function Documentation
void init_uart (void )
AAAAAAAACMAAAAAAAACM
Init the hardware UART with Baud = 76800/38400, depending on BAUD definition, 8 Databits, 1 Stopbit, no Parity.

Returns:
void
Note:
This function depends on the oscillator clock frequency and the BAUD defintion. If your UART is not working first check all frequency issues (Fuse settings, clock speed, clock divider, Baudrate)
Definition at line 432 of file ws2811lichterkette.c.
References MYUBRRMYUBRR.
Referenced by main()main().

ws2811lichterkette.c
1
329 /**************************************************************************/
374 //define global variables
375 #define EXTERN
376 #include "globals.h"
377
378 #include <avr/io.h>
379 #include <util/delay.h>
380 #include <avr/interrupt.h>
381 #include <stdio.h>
382 #include <stdlib.h>
383 #include <string.h>
384
385 #include "Lightstribe.h"
386 #include "LedEffects.h"
387
388 //UART basic definitions
390 #define BAUD 38400
391
392 #define MYUBRR F_CPU/16/BAUD -1
393
394 #define BAUD_REAL (F_CPU/(16*(MYUBRR+1))) /*real baudrate in this configuration*/
395 #define BAUD_ERROR ((BAUD_REAL*1000)/BAUD) /*calculate baudrate error*/
396 #if ((BAUD_ERROR<990) || (BAUD_ERROR>1010))
397 #error baudrate error greater 1% ! /*show an error message if the baudrate error is greater than 1%*/
398 #endif
399
400 //Protocol definition for UART communication
401 //The protocol is defined as:
402 //1 Byte preamble (254)
403 //1 Byte total packet length (including the preamble)
404 //1 Byte effect
405 //1 Byte effect delay (effect speed)
406 //1 Byte number of LEDs to control
407 //n Bytes containing 8-Bit color values (RGB 3-3-2), depended on the effect, max. 50 values
408
410 #define PREAMBLE 254
411
412 #define LENINDEX 1
413
414 #define EFFECTINDEX 2
415
416 #define DELAYINDEX 3
417
418 #define NUMOFLEDINDEX 4
419
420
421 //compiling info output
422 #pragma message("MYUBRR: " _STR(MYUBRR))
423 #pragma message("CPU Frequency: " _STR(F_CPU) "Hz")
424 #pragma message("Baudrate: " _STR(BAUD))
425 #pragma message("Configuration: MAXNUMCOLORS=" _STR(MAXNUMCOLORS) " | UART_BUFFER_SIZE=" _STR(UART_BUFFER_SIZE) " | PREAMBLE=" _STR(PREAMBLE))
426
432 void init_uart(void)
433 {
434 DDRD |= _BV(PD1);
435 DDRD &= ~_BV(PD0);
436
437 //Set BAUD
438 UBRR0H = ((MYUBRR) >> 8);
439 UBRR0L = MYUBRR;
440
441 UCSR0B |= (1 << RXEN0) ;//| (1 << TXEN0); // Enable receiver (and transmitter; commited out)
442 UCSR0B |= (1 << RXCIE0); // Enable the receiver interrupt
443 UCSR0C |= (1 << UCSZ01) | (1 << UCSZ00); // 8 data Bit, one stop Bit
444 }
445
447 int main(void)
448 {
449 uint16_t i,j; //helper variables (counters)
450 uint8_t TempBuffer[UART_BUFFER_SIZE]; //Temp. buffer for copy of the UART data to achieve data consistency
451 uint8_t *lightdata; //lightdata pointer for lightdata array; the array size is dynamic to controll different numbers of LEDs
452
453 NumOfLeds=50; //default number of LEDs is 50 => one stribe
454 //Flag initializations
455 PacketComplete=0;
456 IsReading=0;
457 PaketStart=0;
458 BufferCounter = 0;
459
460 memset(RecBuffer,0,sizeof(RecBuffer[0])*UART_BUFFER_SIZE); //clear the buffer
461 memset(TempBuffer,0,sizeof(RecBuffer[0])*UART_BUFFER_SIZE); //clear the buffer
462 ledtype = BASELEDTYPE; //set default ledtype, 11 =>WS2811, 12 =>WS2812
463
464 //Set the LED output Port (Pin B0 is used for LED data output)
465 DDRB = 0x01;
466 PORTB = 0x00;
467
468 //Basic initializations
469 ReceivedChar = 1;
470 effectime = 10;
471 effect=255;
472 BufferCounter=0;
473
474 init_uart(); //Init the hardware UART
475 sei(); //enable global interrupts
476
477 //main system loop
478 while(1){
479 if (PacketComplete==1) //new UART package containing color and effect data is available
480 {
481 //Prohibit the access to the UART RecBuffer while copying the data to a Temp Buffer
482 IsReading=1;
483 PaketStart=0;
484 memcpy(TempBuffer,RecBuffer,DataLen); //Copy the UART data to a temp array
485 effect=TempBuffer[EFFECTINDEX] & 0x7F; //get the effect from the temp array
486 effectime=TempBuffer[DELAYINDEX]; //get the delay time for the effect form the temp array
487 ledtype=BASELEDTYPE+((TempBuffer[EFFECTINDEX] & 0x80)>>7);//configure the ledtype depending on the MSBit of the effect
488 NumOfLeds=TempBuffer[NUMOFLEDINDEX]; //get the number of leds to control
489 IsReading=0; //allow access to the UART RecBuffer
490 memcpy(CompColorArray,&TempBuffer[5],DataLen-5); //generate compressed color array
491 if (lightdata!=NULL)
492 {
493 free(lightdata);
494 }
495 lightdata = (uint8_t *) malloc (NumOfLeds*3); //allocate the lightdata array for uncompressed colors
496 PacketComplete=0; //reset PacketComplete flag
497 }
498 else
499 {
500 //main switch for effect handling
501 switch(effect)
502 {
503 case SETFULLCOLOR:
504 setfullcolor(colorconv8to24(CompColorArray[0]),lightdata);
505 transmit2leds(lightdata);
506 break;
507 case FILLUP:
508 fillup(colorconv8to24(CompColorArray[0]),colorconv8to24(CompColorArray[1]),lightdata);
509 transmit2leds(lightdata);
510 break;
511 case BLINK:
512 blinkled(colorconv8to24(CompColorArray[0]),lightdata);
513 break;
514 case RUNLED:
515 initrunled(colorconv8to24(CompColorArray[0]),lightdata,colorconv8to24(CompColorArray[1]));
516 effect++;
517 case 4:
518 runrunled(lightdata,1);
519 break;
520 case ALTERNATE:
521 init_alternating(colorconv8to24(CompColorArray[0]),colorconv8to24(CompColorArray[1]),lightdata);
522 effect++;
523 case 6:
524 run_alternating(lightdata);
525 break;
526 case RECOLOR:
527 recolor(colorconv8to24(CompColorArray[0]),lightdata);
528 effect=255;
529 break;
530 case FADE:
531 faden(colorconv8to24(CompColorArray[0]),lightdata);
532 break;
533 case INITRAINBOW:
534 initrainbow(lightdata);
535 transmit2leds(lightdata);
536 break;
537 case ROTATE_R:
538 rotate(lightdata,0);
539 effectdelay(effectime);
540 transmit2leds(lightdata);
541 break;
542 case ROTATE_L:
543 rotate(lightdata,1);
544 effectdelay(effectime);
545 transmit2leds(lightdata);
546 break;
547 case CUSTOM:
548 //The custom effect assigns up to MAXNUMCOLORS individual colors to the stribe
549 //if the number of colors is smaller than the number of LEDs the colors are repeated using
550 //modulo operation
551 for (i=0;i<NumOfLeds;i++)
552 {
553 j = i % (DataLen-5);
554 changeled(colorconv8to24(CompColorArray[j]),lightdata,i);
555 }
556 transmit2leds(lightdata);
557 effect=255;
558 break;
559 case EASTEREGG:
560 easteregg(lightdata);
561 break;
562 default: //do nothing
563 break;
564 }
565 }
566
567
568 }
569
570 }
571
572
574 ISR (USART_RX_vect)
575 {
576 ReceivedChar = UDR0; //Read data from the RX buffer
577 if (ReceivedChar==PREAMBLE && IsReading==0) //Store data in the RecBuffer array only if it is not accessed by the main function
578 {
579 PacketComplete=0;
580 PaketStart=1; //Set packet start flag (-->254=PREAMBLE has been received)
581 memset(RecBuffer,0,sizeof(RecBuffer[0])*UART_BUFFER_SIZE);//clear the buffer
582 BufferCounter=0;
583 RecBuffer[0]=ReceivedChar; //Store the preamble
584 }
585 else if (PaketStart==1)
586 {
587 //Store all Bytes after the preamble
588 BufferCounter++;
589 RecBuffer[BufferCounter]=ReceivedChar;
590 DataLen=RecBuffer[LENINDEX]; //Store data len of the data packet (preamble included)
591 if (DataLen==BufferCounter+1)
592 {
593 PacketComplete=1; //a whole packet has been received, update the effect in main
594 }
595 }
596 }

Index
INDEX
