Flo1991/ws2811lichterkette/Protoll_V1_2.pdf

Präambel | Gesamtlänge | Effekt | Effektge-
schwindigkeit | LED Anzahl | Farbwerte

254

= 1Byte Präambel
+1Byte Gesamtlänge
+1Byte Effekt
+1Byte Effektgeschwindigkeit +1Byte LED Anzahl
+ nByte 8-Bit Farbwerte

0 = SETFULLCOLOR

1 = AUFFUELLEN

2 = BLINK

3 = RUNLED

5 = LAUFLED

7 = NEUFAERBEN

8 = FADEN

9 = INITRAINBOW

10 = ROTATE_R

11 = ROTATE_L

12 = CUSTOM

1Byte 0-250
0: keine Wartezeit
>0: Wartezeit

1Byte 0-200

8-Bit Einzelfarbwerte, 254 nicht verwendbar (überschnitt Präambel) Im Bereich von 0 bis 50

Wartezeit
irrelevant

Anzusteuernde
LEDs | 1 Farbwert

Auffüllgeschwindigkeit

Anzusteuernde
LEDs

1 Farbwert Vordergrund, Index 0 1 Farbwert Hintergrund, Index 1

Blinkgeschwindigkeit

Anzusteuernde
LEDs | 1 Farbwert

Renngeschwindigkeit

Beispielaufruf:
254 7 1 22 20 22 201

Beispielaufruf:
254 6 2 55 20 56

Beispielaufruf:
254 7 3 55 20 56 151

Anzusteuernde
LEDs

1 Farbwert Vordergrund, Index 0 1 Farbwert Hintergrund, Index 1

Laufgeschwindigkeit

Anzusteuernde
LEDs

1 Farbwert Vordergrund, Index 0 1 Farbwert Hintergrund, Index 1

Beispielaufruf:
254 7 5 55 20 56 151

Einfärbeschwindigkeit

Fadegeschwindigkeit

Wartezeit
irrelevant

Rotiergeschwindigkeit

Rotiergeschwindigkeit

Laufgeschwindigkeit

Beispielaufruf:
254 6 7 55 20 38

Anzusteuernde
LEDs | 1 Farbwert

Beispielaufruf:
254 6 8 55 20 201

Anzusteuernde
LEDs | 1 Farbwert

Anzusteuernde

LEDs | Kein Farbwert Beispielaufruf:
254 5 9 0 20

Anzusteuernde
LEDs

Anzusteuernde
LEDs

Anzusteuernde
LEDs

Kein Farbwert Beispielaufruf: 254 5 10 232 20

Kein Farbwert Beispielaufruf: 254 5 11 23 20

Beispielaufruf:
254 8 12 1 20 22 201 60

N Farbwerte
mit 0<n<51

Beispielaufruf:
254 6 0 1 20 22

1 Bit LEDTYPE
7 Bit Effekt

MSb = 0 →WS2811
MSb = 1 →WS2812
Effektbeschreibung

Alle LEDs leuchten dauerhaft einfarbig

Eine LED bewegt sich in der Vordergrundfarbe zunächst schrittweise durch die Lichterkette und zieht hinter sich alle LEDs auf die Hintergrundfarbe. Anschließend folgt jeweils eine LED, sodass die Lichterkette schrittweise mit der Vordergrundfarbe aufgefüllt wird.

Die Lichterkette leuchtet abwechselnd komplett einfarbig beziehungsweise ist aus

Alle LEDs leuchten in der Hintergrundfarbe, eine einzelne LED durchläuft die Lichterkette schrittweise in der Vordergrundfarbe und beginnt am Ende der Lichterkette von vorne

Die LEDs werden in abwechselnder Reihenfolge mit der Vordergrundfarbe bzw. Hintergrundfarbe angesteuert. Diese Position wechselt schrittweise bezüglich aller LEDs.

Die Lichterkette wird schrittweise mit einer neuen Farbe eingefärbt, sodass Schritt für Schritt mehr LEDs in der Zielfarbe leuchten. Am Effektende leuchtet die Lichterkette einfarbig.

Die Zielfarbe wird eingestellt und die Farbwerte werden je Grundfarbton (Rot, Grün, Blau) schrittweise verringert und anschließend erhöht. Dadurch werden verschiedene Farbtöne überlaufen, die Lichterkette wird ganz dunkel und erhöht dann schrittweise wieder die Farbwerte.

Die Lichterkette wird in einem statischen Regenbogenmuster angesteuert.

Die LEDs werden alle einen Platz weitergeschoben („Richtung rechts“)

Die LEDs werden alle einen Platz weitergeschoben („Richtung links“)

Die anzusteuernden LEDs werden statisch anhand der vorgegebenen Farbwerte angesteuert. Wenn die Anzahl der LEDs größer als die verfügbaren Farbwerte sind werden die Farben wiederholt

13 = EASTEREGG Beispielaufruf: 254 5 13 2 20
