Flo1991/ws2811lichterkette/Doxy/latex/ws2811lichterkette_8c_source.tex

\hypertarget{ws2811lichterkette_8c_source}{}\subsection{ws2811lichterkette.\+c}

\begin{DoxyCode}
00001 
00329 \textcolor{comment}{/**************************************************************************/}
00374 \textcolor{comment}{//define global variables}
00375 \textcolor{preprocessor}{#define EXTERN}
00376 \textcolor{preprocessor}{#include "\hyperlink{globals_8h}{globals.h}"}
00377 
00378 \textcolor{preprocessor}{#include <avr/io.h>}
00379 \textcolor{preprocessor}{#include <util/delay.h>}
00380 \textcolor{preprocessor}{#include <avr/interrupt.h>}
00381 \textcolor{preprocessor}{#include <stdio.h>}      
00382 \textcolor{preprocessor}{#include <stdlib.h>}    
00383 \textcolor{preprocessor}{#include <string.h>}
00384 
00385 \textcolor{preprocessor}{#include "\hyperlink{_lightstribe_8h}{Lightstribe.h}"}
00386 \textcolor{preprocessor}{#include "\hyperlink{_led_effects_8h}{LedEffects.h}"}
00387 
00388 \textcolor{comment}{//UART basic definitions}
\hypertarget{ws2811lichterkette_8c_source_l00390}{}\hyperlink{ws2811lichterkette_8c_a62634036639f88eece6fbf226b45f84b}{00390} \textcolor{comment}{}\textcolor{preprocessor}{#define BAUD 38400  }
00391 
\hypertarget{ws2811lichterkette_8c_source_l00392}{}\hyperlink{ws2811lichterkette_8c_a711e9130c825a7269c8c87dbb57a85e0}{00392} \textcolor{preprocessor}{#define MYUBRR F\_CPU/16/BAUD -1}
00393 
00394 \textcolor{preprocessor}{#define BAUD\_REAL (F\_CPU/(16*(MYUBRR+1)))       }\textcolor{comment}{/*real baudrate in this configuration*/}\textcolor{preprocessor}{}
00395 \textcolor{preprocessor}{#define BAUD\_ERROR ((BAUD\_REAL*1000)/BAUD)      }\textcolor{comment}{/*calculate baudrate error*/}\textcolor{preprocessor}{    }
00396 \textcolor{preprocessor}{#if ((BAUD\_ERROR<990) || (BAUD\_ERROR>1010))}
00397 \textcolor{preprocessor}{    #error baudrate error greater 1% !          }\textcolor{comment}{/*show an error message if the baudrate error is greater
       than 1%*/}\textcolor{preprocessor}{}
00398 \textcolor{preprocessor}{#endif}
00399 
00400 \textcolor{comment}{//Protocol definition for UART communication}
00401 \textcolor{comment}{//The protocol is defined as:}
00402 \textcolor{comment}{//1 Byte preamble (254)}
00403 \textcolor{comment}{//1 Byte total packet length (including the preamble)}
00404 \textcolor{comment}{//1 Byte effect}
00405 \textcolor{comment}{//1 Byte effect delay (effect speed)}
00406 \textcolor{comment}{//1 Byte number of LEDs to control}
00407 \textcolor{comment}{//n Bytes containing 8-Bit color values (RGB 3-3-2), depended on the effect, max. 50 values}
00408 
\hypertarget{ws2811lichterkette_8c_source_l00410}{}\hyperlink{ws2811lichterkette_8c_a8aac8c5098aaf915463fb31715efa09f}{00410} \textcolor{preprocessor}{#define PREAMBLE 254        }
00411 
\hypertarget{ws2811lichterkette_8c_source_l00412}{}\hyperlink{ws2811lichterkette_8c_aec9ae4a8d59e838ac8ed93ad0de8e827}{00412} \textcolor{preprocessor}{#define LENINDEX 1          }
00413 
\hypertarget{ws2811lichterkette_8c_source_l00414}{}\hyperlink{ws2811lichterkette_8c_a8d4e4cf47dd6136ace963623e1a8e27c}{00414} \textcolor{preprocessor}{#define EFFECTINDEX 2       }
00415 
\hypertarget{ws2811lichterkette_8c_source_l00416}{}\hyperlink{ws2811lichterkette_8c_a9ff437877d0878dd16eacf103a1e1c40}{00416} \textcolor{preprocessor}{#define DELAYINDEX 3        }
00417 
\hypertarget{ws2811lichterkette_8c_source_l00418}{}\hyperlink{ws2811lichterkette_8c_afbc75dc20761a05dda7cbb70b9b322dd}{00418} \textcolor{preprocessor}{#define NUMOFLEDINDEX 4     }
00419 
00420 
00421 \textcolor{comment}{//compiling info output}
00422 \textcolor{preprocessor}{#pragma message("MYUBRR: " \_STR(MYUBRR))}
00423 \textcolor{preprocessor}{#pragma message("CPU Frequency: " \_STR(F\_CPU) "Hz")}
00424 \textcolor{preprocessor}{#pragma message("Baudrate: " \_STR(BAUD))}
00425 \textcolor{preprocessor}{#pragma message("Configuration: MAXNUMCOLORS=" \_STR(MAXNUMCOLORS)  " | UART\_BUFFER\_SIZE="
       \_STR(UART\_BUFFER\_SIZE) " | PREAMBLE=" \_STR(PREAMBLE))}
00426 
\hypertarget{ws2811lichterkette_8c_source_l00432}{}\hyperlink{ws2811lichterkette_8c_ac7b3df0fa68526d64c732d5f916e34b1}{00432} \textcolor{keywordtype}{void} \hyperlink{ws2811lichterkette_8c_ac7b3df0fa68526d64c732d5f916e34b1}{init\_uart}(\textcolor{keywordtype}{void})
00433 \{
00434     DDRD |= \_BV(PD1);
00435     DDRD &= ~\_BV(PD0);
00436     
00437      \textcolor{comment}{//Set BAUD}
00438      UBRR0H = ((\hyperlink{ws2811lichterkette_8c_a711e9130c825a7269c8c87dbb57a85e0}{MYUBRR}) >> 8);
00439      UBRR0L = \hyperlink{ws2811lichterkette_8c_a711e9130c825a7269c8c87dbb57a85e0}{MYUBRR};
00440      
00441      UCSR0B |= (1 << RXEN0) ;\textcolor{comment}{//| (1 << TXEN0);      // Enable receiver (and transmitter; commited out)}
00442      UCSR0B |= (1 << RXCIE0);                       \textcolor{comment}{// Enable the receiver interrupt}
00443      UCSR0C |= (1 << UCSZ01) | (1 << UCSZ00);       \textcolor{comment}{// 8 data Bit, one stop Bit}
00444 \}
00445 
\hypertarget{ws2811lichterkette_8c_source_l00447}{}\hyperlink{ws2811lichterkette_8c_a840291bc02cba5474a4cb46a9b9566fe}{00447} \textcolor{keywordtype}{int} \hyperlink{ws2811lichterkette_8c_a840291bc02cba5474a4cb46a9b9566fe}{main}(\textcolor{keywordtype}{void})
00448 \{
00449     uint16\_t i,j;                           \textcolor{comment}{//helper variables (counters)}
00450     uint8\_t TempBuffer[\hyperlink{globals_8h_a0d57378e32bf8278011460740bc29f7f}{UART\_BUFFER\_SIZE}];   \textcolor{comment}{//Temp. buffer for copy of the UART data to
       achieve data consistency    }
00451     uint8\_t *lightdata;                     \textcolor{comment}{//lightdata pointer for lightdata array; the array size is
       dynamic to controll different numbers of LEDs}
00452     
00453     \hyperlink{globals_8h_ad5db4045aed262ed4aae2af9d81fab98}{NumOfLeds}=50;                          \textcolor{comment}{//default number of LEDs is 50 => one stribe}
00454     \textcolor{comment}{//Flag initializations}
00455     \hyperlink{globals_8h_a1b09d1a5bcf4c8ab435bb3c9e36def59}{PacketComplete}=0;                         
00456     \hyperlink{globals_8h_a922ad5baed647eca43ad1a979e162ebd}{IsReading}=0;
00457     \hyperlink{globals_8h_aaa3bddd2273257ac5ec259197b62e984}{PaketStart}=0; 
00458     \hyperlink{globals_8h_aa6fcb4d4fca4554ac73bef10668c23cd}{BufferCounter} = 0;
00459 
00460     memset(\hyperlink{globals_8h_a5d735865707e6694a8173d629e0b4d5c}{RecBuffer},0,\textcolor{keyword}{sizeof}(\hyperlink{globals_8h_a5d735865707e6694a8173d629e0b4d5c}{RecBuffer}[0])*\hyperlink{globals_8h_a0d57378e32bf8278011460740bc29f7f}{UART\_BUFFER\_SIZE});    \textcolor{comment}{//clear
       the buffer  }
00461     memset(TempBuffer,0,\textcolor{keyword}{sizeof}(\hyperlink{globals_8h_a5d735865707e6694a8173d629e0b4d5c}{RecBuffer}[0])*UART\_BUFFER\_SIZE);    \textcolor{comment}{//clear the buffer}
00462     \hyperlink{globals_8h_a722e1eb38b661d1338ada3cc7a4049a0}{ledtype} = \hyperlink{globals_8h_af07a5ce170c7be13d096843960e7b9da}{BASELEDTYPE};                    \textcolor{comment}{//set default ledtype, 11 =>WS2811, 12
       =>WS2812}
00463     
00464     \textcolor{comment}{//Set the LED output Port (Pin B0 is used for LED data output)}
00465     DDRB = 0x01;                        
00466     PORTB = 0x00;
00467 
00468     \textcolor{comment}{//Basic initializations}
00469     \hyperlink{globals_8h_ab5490074aaca289e986e9a00e0c25663}{ReceivedChar} = 1;
00470     \hyperlink{globals_8h_ac2445d316b2972d381edeac44bb6a226}{effectime} = 10;
00471     \hyperlink{globals_8h_a053b8e1f039c19251b90d60317db8aed}{effect}=255;
00472     \hyperlink{globals_8h_aa6fcb4d4fca4554ac73bef10668c23cd}{BufferCounter}=0;
00473     
00474     \hyperlink{ws2811lichterkette_8c_ac7b3df0fa68526d64c732d5f916e34b1}{init\_uart}();                           \textcolor{comment}{//Init the hardware UART}
00475     sei();                                  \textcolor{comment}{//enable global interrupts}
00476 
00477     \textcolor{comment}{//main system loop}
00478     \textcolor{keywordflow}{while}(1)\{
00479         \textcolor{keywordflow}{if} (\hyperlink{globals_8h_a1b09d1a5bcf4c8ab435bb3c9e36def59}{PacketComplete}==1)    \textcolor{comment}{//new UART package containing color and effect data is
       available}
00480         \{
00481             \textcolor{comment}{//Prohibit the access to the UART RecBuffer while copying the data to a Temp Buffer}
00482             \hyperlink{globals_8h_a922ad5baed647eca43ad1a979e162ebd}{IsReading}=1;       
00483             \hyperlink{globals_8h_aaa3bddd2273257ac5ec259197b62e984}{PaketStart}=0;
00484             memcpy(TempBuffer,\hyperlink{globals_8h_a5d735865707e6694a8173d629e0b4d5c}{RecBuffer},\hyperlink{globals_8h_aaa611e00c18e950be43a4cd5ce0ceeb1}{DataLen});   \textcolor{comment}{//Copy the UART data to a temp array    }
00485             \hyperlink{globals_8h_a053b8e1f039c19251b90d60317db8aed}{effect}=TempBuffer[\hyperlink{ws2811lichterkette_8c_a8d4e4cf47dd6136ace963623e1a8e27c}{EFFECTINDEX}] & 0x7F; \textcolor{comment}{//get the effect from the temp array}
00486             \hyperlink{globals_8h_ac2445d316b2972d381edeac44bb6a226}{effectime}=TempBuffer[\hyperlink{ws2811lichterkette_8c_a9ff437877d0878dd16eacf103a1e1c40}{DELAYINDEX}];        \textcolor{comment}{//get the delay time for the effect
       form the temp array}
00487             \hyperlink{globals_8h_a722e1eb38b661d1338ada3cc7a4049a0}{ledtype}=\hyperlink{globals_8h_af07a5ce170c7be13d096843960e7b9da}{BASELEDTYPE}+((TempBuffer[\hyperlink{ws2811lichterkette_8c_a8d4e4cf47dd6136ace963623e1a8e27c}{EFFECTINDEX}] & 0x80)>>7);\textcolor{comment}{//
      configure the ledtype depending on the MSBit of the effect}
00488             \hyperlink{globals_8h_ad5db4045aed262ed4aae2af9d81fab98}{NumOfLeds}=TempBuffer[\hyperlink{ws2811lichterkette_8c_afbc75dc20761a05dda7cbb70b9b322dd}{NUMOFLEDINDEX}];  \textcolor{comment}{//get the number of leds to control}
00489             \hyperlink{globals_8h_a922ad5baed647eca43ad1a979e162ebd}{IsReading}=0;                           \textcolor{comment}{//allow access to the UART RecBuffer}
00490             memcpy(\hyperlink{globals_8h_a159854edb9d0c7283013495d85bdf997}{CompColorArray},&TempBuffer[5],\hyperlink{globals_8h_aaa611e00c18e950be43a4cd5ce0ceeb1}{DataLen}-5);   \textcolor{comment}{//generate compressed
       color array}
00491             \textcolor{keywordflow}{if} (lightdata!=NULL)
00492             \{
00493                 free(lightdata);
00494             \}
00495             lightdata = (uint8\_t *) malloc (\hyperlink{globals_8h_ad5db4045aed262ed4aae2af9d81fab98}{NumOfLeds}*3);      \textcolor{comment}{//allocate the lightdata array for
       uncompressed colors}
00496             \hyperlink{globals_8h_a1b09d1a5bcf4c8ab435bb3c9e36def59}{PacketComplete}=0;                     \textcolor{comment}{//reset PacketComplete flag}
00497         \}
00498         \textcolor{keywordflow}{else}
00499         \{
00500             \textcolor{comment}{//main switch for effect handling}
00501             \textcolor{keywordflow}{switch}(\hyperlink{globals_8h_a053b8e1f039c19251b90d60317db8aed}{effect})
00502             \{
00503                 \textcolor{keywordflow}{case} \hyperlink{_led_effects_8h_a996334f1d53296a931624800377d5b01}{SETFULLCOLOR}:
00504                     \hyperlink{_led_effects_8c_a2d54d1a6c61fe667b7c68ff04a11c503}{setfullcolor}(\hyperlink{_led_effects_8c_a55291315ab0f2ca8d508f0e9da1920a7}{colorconv8to24}(
      \hyperlink{globals_8h_a159854edb9d0c7283013495d85bdf997}{CompColorArray}[0]),lightdata);
00505                     \hyperlink{_lightstribe_8c_aac724dad670e4a26723daf71ce6a8d8a}{transmit2leds}(lightdata);
00506                     \textcolor{keywordflow}{break};
00507                 \textcolor{keywordflow}{case} \hyperlink{_led_effects_8h_a2f349ea8f5412514d90f138ede08da62}{FILLUP}:
00508                     \hyperlink{_led_effects_8c_a99174e2b381d7ec6667d29352e6eca1b}{fillup}(\hyperlink{_led_effects_8c_a55291315ab0f2ca8d508f0e9da1920a7}{colorconv8to24}(\hyperlink{globals_8h_a159854edb9d0c7283013495d85bdf997}{CompColorArray}[0]),
      \hyperlink{_led_effects_8c_a55291315ab0f2ca8d508f0e9da1920a7}{colorconv8to24}(\hyperlink{globals_8h_a159854edb9d0c7283013495d85bdf997}{CompColorArray}[1]),lightdata);
00509                     \hyperlink{_lightstribe_8c_aac724dad670e4a26723daf71ce6a8d8a}{transmit2leds}(lightdata);
00510                     \textcolor{keywordflow}{break};
00511                 \textcolor{keywordflow}{case} \hyperlink{_led_effects_8h_a38eec52a7dccb94ff563e30eda32c891}{BLINK}:
00512                     \hyperlink{_led_effects_8c_a9fd87d01d5cc4ce5fce6ddca55ebaf37}{blinkled}(\hyperlink{_led_effects_8c_a55291315ab0f2ca8d508f0e9da1920a7}{colorconv8to24}(\hyperlink{globals_8h_a159854edb9d0c7283013495d85bdf997}{CompColorArray}[0]),
      lightdata);
00513                     \textcolor{keywordflow}{break};
00514                 \textcolor{keywordflow}{case} \hyperlink{_led_effects_8h_ab6e06c8b4c17edc65d75be641a0fc39b}{RUNLED}:
00515                     \hyperlink{_led_effects_8c_aecba07ab559ab94e6f44c16e39012d80}{initrunled}(\hyperlink{_led_effects_8c_a55291315ab0f2ca8d508f0e9da1920a7}{colorconv8to24}(
      \hyperlink{globals_8h_a159854edb9d0c7283013495d85bdf997}{CompColorArray}[0]),lightdata,\hyperlink{_led_effects_8c_a55291315ab0f2ca8d508f0e9da1920a7}{colorconv8to24}(
      \hyperlink{globals_8h_a159854edb9d0c7283013495d85bdf997}{CompColorArray}[1]));
00516                     \hyperlink{globals_8h_a053b8e1f039c19251b90d60317db8aed}{effect}++;
00517                 \textcolor{keywordflow}{case} 4:
00518                     \hyperlink{_led_effects_8c_a35cfbfc36c975f98a7779a37b6ff63ce}{runrunled}(lightdata,1);
00519                     \textcolor{keywordflow}{break};
00520                 \textcolor{keywordflow}{case} \hyperlink{_led_effects_8h_ac7190c598c8618207180d135c0650dac}{ALTERNATE}:
00521                     \hyperlink{_led_effects_8c_af67b7638a175e4971f25df5a5db3d8d0}{init\_alternating}(\hyperlink{_led_effects_8c_a55291315ab0f2ca8d508f0e9da1920a7}{colorconv8to24}(
      \hyperlink{globals_8h_a159854edb9d0c7283013495d85bdf997}{CompColorArray}[0]),\hyperlink{_led_effects_8c_a55291315ab0f2ca8d508f0e9da1920a7}{colorconv8to24}(\hyperlink{globals_8h_a159854edb9d0c7283013495d85bdf997}{CompColorArray}[1]),lightdata);
00522                     \hyperlink{globals_8h_a053b8e1f039c19251b90d60317db8aed}{effect}++;
00523                 \textcolor{keywordflow}{case} 6:
00524                     \hyperlink{_led_effects_8c_a5bde1e9e7fc19a9916f1ec02d8fbcd6c}{run\_alternating}(lightdata);
00525                     \textcolor{keywordflow}{break};
00526                 \textcolor{keywordflow}{case} \hyperlink{_led_effects_8h_a6b71fe4d23960c3701fc935a3368a6cc}{RECOLOR}:
00527                     \hyperlink{_led_effects_8c_a448758d76f47ea6fed4beb349196363f}{recolor}(\hyperlink{_led_effects_8c_a55291315ab0f2ca8d508f0e9da1920a7}{colorconv8to24}(\hyperlink{globals_8h_a159854edb9d0c7283013495d85bdf997}{CompColorArray}[0]),lightdata)
      ;
00528                     \hyperlink{globals_8h_a053b8e1f039c19251b90d60317db8aed}{effect}=255;
00529                     \textcolor{keywordflow}{break};
00530                 \textcolor{keywordflow}{case} \hyperlink{_led_effects_8h_ad8150289b0e08f01126500379852a2a7}{FADE}:
00531                     \hyperlink{_led_effects_8c_a71d3b2ff21a63b48a01461e74be0c2b8}{faden}(\hyperlink{_led_effects_8c_a55291315ab0f2ca8d508f0e9da1920a7}{colorconv8to24}(\hyperlink{globals_8h_a159854edb9d0c7283013495d85bdf997}{CompColorArray}[0]),lightdata);
00532                     \textcolor{keywordflow}{break};
00533                 \textcolor{keywordflow}{case} \hyperlink{_led_effects_8h_a2805176df86592658ae06a508a558720}{INITRAINBOW}:
00534                     \hyperlink{_led_effects_8c_a9d0f91360c87b851925bf05be5352435}{initrainbow}(lightdata);
00535                     \hyperlink{_lightstribe_8c_aac724dad670e4a26723daf71ce6a8d8a}{transmit2leds}(lightdata);
00536                     \textcolor{keywordflow}{break};
00537                 \textcolor{keywordflow}{case} \hyperlink{_led_effects_8h_a85bd242525add173bd67847b7acac00b}{ROTATE\_R}:
00538                     \hyperlink{_led_effects_8c_afd64325b08e785d37b4dfaf358e517f0}{rotate}(lightdata,0);
00539                     \hyperlink{_led_effects_8c_a6950e7657ba74d0d490ba36427533c4b}{effectdelay}(\hyperlink{globals_8h_ac2445d316b2972d381edeac44bb6a226}{effectime});
00540                     \hyperlink{_lightstribe_8c_aac724dad670e4a26723daf71ce6a8d8a}{transmit2leds}(lightdata);
00541                     \textcolor{keywordflow}{break};
00542                 \textcolor{keywordflow}{case} \hyperlink{_led_effects_8h_a4a0c329f45825186172aee0c62531423}{ROTATE\_L}:
00543                     \hyperlink{_led_effects_8c_afd64325b08e785d37b4dfaf358e517f0}{rotate}(lightdata,1);
00544                     \hyperlink{_led_effects_8c_a6950e7657ba74d0d490ba36427533c4b}{effectdelay}(\hyperlink{globals_8h_ac2445d316b2972d381edeac44bb6a226}{effectime});
00545                     \hyperlink{_lightstribe_8c_aac724dad670e4a26723daf71ce6a8d8a}{transmit2leds}(lightdata);
00546                     \textcolor{keywordflow}{break};
00547                 \textcolor{keywordflow}{case} \hyperlink{_led_effects_8h_a686dea444026cbf1236c24e7edb3a96d}{CUSTOM}:
00548                 \textcolor{comment}{//The custom effect assigns up to MAXNUMCOLORS individual colors to the stribe}
00549                 \textcolor{comment}{//if the number of colors is smaller than the number of LEDs the colors are repeated using}
00550                 \textcolor{comment}{//modulo operation}
00551                     \textcolor{keywordflow}{for} (i=0;i<\hyperlink{globals_8h_ad5db4045aed262ed4aae2af9d81fab98}{NumOfLeds};i++)
00552                     \{
00553                         j = i % (\hyperlink{globals_8h_aaa611e00c18e950be43a4cd5ce0ceeb1}{DataLen}-5);
00554                         \hyperlink{_lightstribe_8c_a63fa595d401f0e85c1bba55ba2b1d66e}{changeled}(\hyperlink{_led_effects_8c_a55291315ab0f2ca8d508f0e9da1920a7}{colorconv8to24}(
      \hyperlink{globals_8h_a159854edb9d0c7283013495d85bdf997}{CompColorArray}[j]),lightdata,i);
00555                     \}
00556                     \hyperlink{_lightstribe_8c_aac724dad670e4a26723daf71ce6a8d8a}{transmit2leds}(lightdata);
00557                     \hyperlink{globals_8h_a053b8e1f039c19251b90d60317db8aed}{effect}=255;
00558                     \textcolor{keywordflow}{break};
00559                 \textcolor{keywordflow}{case} \hyperlink{_led_effects_8h_a5645ec20d3cd39bfc1c9ad5ec99db2f2}{EASTEREGG}:
00560                     \hyperlink{_led_effects_8c_a25e09bcb1481b20ebc2a27e7098b5115}{easteregg}(lightdata);
00561                     \textcolor{keywordflow}{break};
00562                 \textcolor{keywordflow}{default}:    \textcolor{comment}{//do nothing}
00563                     \textcolor{keywordflow}{break};
00564             \}
00565         \}
00566         
00567         
00568     \}
00569       
00570 \}
00571 
00572 
\hypertarget{ws2811lichterkette_8c_source_l00574}{}\hyperlink{ws2811lichterkette_8c_a09ce999e15ad60b8a3f07d08af1946f9}{00574} \hyperlink{ws2811lichterkette_8c_a09ce999e15ad60b8a3f07d08af1946f9}{ISR} (USART\_RX\_vect)
00575 \{
00576     \hyperlink{globals_8h_ab5490074aaca289e986e9a00e0c25663}{ReceivedChar} = UDR0;                            \textcolor{comment}{//Read data from the RX buffer     }
00577     \textcolor{keywordflow}{if} (\hyperlink{globals_8h_ab5490074aaca289e986e9a00e0c25663}{ReceivedChar}==\hyperlink{ws2811lichterkette_8c_a8aac8c5098aaf915463fb31715efa09f}{PREAMBLE} && \hyperlink{globals_8h_a922ad5baed647eca43ad1a979e162ebd}{IsReading}==0)        \textcolor{comment}{//Store data in the
       RecBuffer array only if it is not accessed by the main function}
00578     \{
00579         \hyperlink{globals_8h_a1b09d1a5bcf4c8ab435bb3c9e36def59}{PacketComplete}=0;
00580         \hyperlink{globals_8h_aaa3bddd2273257ac5ec259197b62e984}{PaketStart}=1;                             \textcolor{comment}{//Set packet start flag (-->254=PREAMBLE has
       been received)}
00581         memset(\hyperlink{globals_8h_a5d735865707e6694a8173d629e0b4d5c}{RecBuffer},0,\textcolor{keyword}{sizeof}(\hyperlink{globals_8h_a5d735865707e6694a8173d629e0b4d5c}{RecBuffer}[0])*
      \hyperlink{globals_8h_a0d57378e32bf8278011460740bc29f7f}{UART\_BUFFER\_SIZE});\textcolor{comment}{//clear the buffer    }
00582         \hyperlink{globals_8h_aa6fcb4d4fca4554ac73bef10668c23cd}{BufferCounter}=0;
00583         \hyperlink{globals_8h_a5d735865707e6694a8173d629e0b4d5c}{RecBuffer}[0]=\hyperlink{globals_8h_ab5490074aaca289e986e9a00e0c25663}{ReceivedChar};                 \textcolor{comment}{//Store the preamble}
00584     \}
00585     \textcolor{keywordflow}{else} \textcolor{keywordflow}{if} (\hyperlink{globals_8h_aaa3bddd2273257ac5ec259197b62e984}{PaketStart}==1)
00586     \{
00587         \textcolor{comment}{//Store all Bytes after the preamble}
00588         \hyperlink{globals_8h_aa6fcb4d4fca4554ac73bef10668c23cd}{BufferCounter}++;    
00589         \hyperlink{globals_8h_a5d735865707e6694a8173d629e0b4d5c}{RecBuffer}[\hyperlink{globals_8h_aa6fcb4d4fca4554ac73bef10668c23cd}{BufferCounter}]=\hyperlink{globals_8h_ab5490074aaca289e986e9a00e0c25663}{ReceivedChar};
00590         \hyperlink{globals_8h_aaa611e00c18e950be43a4cd5ce0ceeb1}{DataLen}=\hyperlink{globals_8h_a5d735865707e6694a8173d629e0b4d5c}{RecBuffer}[\hyperlink{ws2811lichterkette_8c_aec9ae4a8d59e838ac8ed93ad0de8e827}{LENINDEX}];                \textcolor{comment}{//Store data len of the data
       packet (preamble included)}
00591         \textcolor{keywordflow}{if} (\hyperlink{globals_8h_aaa611e00c18e950be43a4cd5ce0ceeb1}{DataLen}==\hyperlink{globals_8h_aa6fcb4d4fca4554ac73bef10668c23cd}{BufferCounter}+1)
00592         \{
00593             \hyperlink{globals_8h_a1b09d1a5bcf4c8ab435bb3c9e36def59}{PacketComplete}=1;                     \textcolor{comment}{//a whole packet has been received, update
       the effect in main}
00594         \}        
00595     \}    
00596 \}
\end{DoxyCode}
