Flo1991/ws2811lichterkette/Doxy/html/tree.png

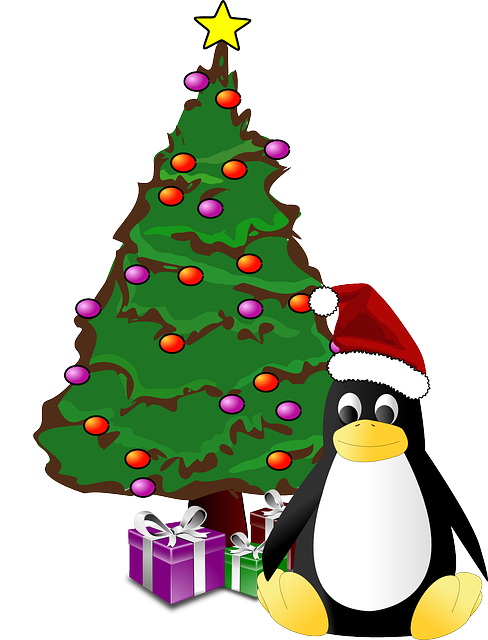
Doxy/html/tree.png
